pringithub/stylosynth-555/hardware/kicad/drc_report.txt

** Drc report for /home/pring5/Projects/Personal/Active/pcb_synthesizer/hardware/kicad/stylosynth.kicad_pcb **
** Created on 2026-09-23 13:34:57 **

** Found 112 DRC violations **
[silk_overlap]: Silkscreen overlap
    Rule: board setup constraints silk; Severity: warning
    @(172.6000 mm, 60.5000 mm): PCB Text 'STYLUS' on F.Silkscreen
    @(171.0000 mm, 61.0000 mm): Reference 'C7'
[silk_overlap]: Silkscreen overlap
    Rule: board setup constraints silk; Severity: warning
    @(161.1500 mm, 72.2100 mm): Line on F.Silkscreen
    @(161.5000 mm, 65.0000 mm): Reference 'C6'
[silk_overlap]: Silkscreen overlap
    Rule: board setup constraints silk; Severity: warning
    @(169.1300 mm, 70.7750 mm): Reference 'R5'
    @(168.0000 mm, 72.0450 mm): Circle on F.Silkscreen
[silk_overlap]: Silkscreen overlap
    Rule: board setup constraints silk; Severity: warning
    @(174.6300 mm, 64.7750 mm): Reference 'R3'
    @(174.7200 mm, 62.1300 mm): Line on F.Silkscreen
[silk_overlap]: Silkscreen overlap
    Rule: board setup constraints silk; Severity: warning
    @(150.0000 mm, 90.5450 mm): Circle on F.Silkscreen
    @(151.6300 mm, 89.2750 mm): Reference 'R103'
[silk_overlap]: Silkscreen overlap
    Rule: board setup constraints silk; Severity: warning
    @(155.6300 mm, 89.2750 mm): Reference 'R102'
    @(154.0000 mm, 90.5450 mm): Circle on F.Silkscreen
[silk_overlap]: Silkscreen overlap
    Rule: board setup constraints silk; Severity: warning
    @(62.0973 mm, 84.7500 mm): Reference 'C1'
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
    Local override; Severity: warning
    @(168.0000 mm, 72.0450 mm): Footprint R4
[lib_footprint_issues]: Footprint 'R_Axial_DIN0207_L6.3mm_D2.5mm_P2.54mm_Vertical' not found in library 'Resistor_THT'.
    Local override; Severity: warning
    @(112.6500 mm, 90.5450 mm): Footprint R112
[lib_footprint_issues]: Footprint 'C_Disc_D5.0mm_W2.5mm_P5.00mm' not found in library 'Capacitor_THT'.
    Local override; Severity: warning
    @(174.5000 mm, 72.0000 mm): Footprint C8
[lib_footprint_issues]: Footprint 'MountingHole_3.2mm_M3' not found in library 'MountingHole'.
    Local override; Severity: warning
    @(54.0000 mm, 134.0000 mm): Footprint H3
[lib_footprint_issues]: Footprint 'R_Axial_DIN0207_L6.3mm_D2.5mm_P2.54mm_Vertical' not found in library 'Resistor_THT'.
    Local override; Severity: warning
    @(98.0000 mm, 90.5450 mm): Footprint R115
[lib_footprint_issues]: Footprint 'TO-92_Inline' not found in library 'Package_TO_SOT_THT'.
    Local override; Severity: warning
    @(60.7300 mm, 109.3600 mm): Footprint U1
[lib_footprint_issues]: Footprint 'CP_Radial_D5.0mm_P2.00mm' not found in library 'Capacitor_THT'.
    Local override; Severity: warning
    @(119.0449 mm, 78.0000 mm): Footprint C12
[lib_footprint_issues]: Footprint 'DIP-8_W7.62mm_Socket' not found in library 'Package_DIP'.
    Local override; Severity: warning
    @(152.2000 mm, 63.2000 mm): Footprint U2
[lib_footprint_issues]: Footprint 'C_Disc_D5.0mm_W2.5mm_P5.00mm' not found in library 'Capacitor_THT'.
    Local override; Severity: warning
    @(128.0000 mm, 79.5000 mm): Footprint C14
[lib_footprint_issues]: Footprint 'C_Disc_D5.0mm_W2.5mm_P5.00mm' not found in library 'Capacitor_THT'.
    Local override; Severity: warning
    @(104.0000 mm, 68.5000 mm): Footprint C9
[lib_footprint_issues]: Footprint 'R_Axial_DIN0207_L6.3mm_D2.5mm_P2.54mm_Vertical' not found in library 'Resistor_THT'.
    Local override; Severity: warning
    @(122.0000 mm, 90.5450 mm): Footprint R110
[lib_footprint_issues]: Footprint 'C_Rect_L7.2mm_W3.5mm_P5.00mm_FKS2_FKP2_MKS2_MKP2' not found in library 'Capacitor_THT'.
    Local override; Severity: warning
    @(168.5000 mm, 64.0000 mm): Footprint C7
[lib_footprint_issues]: Footprint 'R_Axial_DIN0207_L6.3mm_D2.5mm_P2.54mm_Vertical' not found in library 'Resistor_THT'.
    Local override; Severity: warning
    @(133.0000 mm, 77.0450 mm): Footprint R8
[lib_footprint_issues]: Footprint 'CP_Radial_D5.0mm_P2.00mm' not found in library 'Capacitor_THT'.
    Local override; Severity: warning
    @(77.0449 mm, 75.0000 mm): Footprint C19
[lib_footprint_issues]: Footprint 'R_Axial_DIN0207_L6.3mm_D2.5mm_P2.54mm_Vertical' not found in library 'Resistor_THT'.
    Local override; Severity: warning
    @(108.5000 mm, 66.0450 mm): Footprint R7
[lib_footprint_issues]: Footprint 'SW_CK_JS202011CQN_DPDT_Straight' not found in library 'Button_Switch_THT'.
    Local override; Severity: warning
    @(121.3000 mm, 44.3575 mm): Footprint SW3
[lib_footprint_issues]: Footprint 'R_Axial_DIN0207_L6.3mm_D2.5mm_P2.54mm_Vertical' not found in library 'Resistor_THT'.
    Local override; Severity: warning
    @(171.5000 mm, 72.0450 mm): Footprint R5
[lib_footprint_issues]: Footprint 'R_Axial_DIN0207_L6.3mm_D2.5mm_P2.54mm_Vertical' not found in library 'Resistor_THT'.
    Local override; Severity: warning
    @(126.0000 mm, 90.5450 mm): Footprint R109
[lib_footprint_issues]: Footprint 'R_Axial_DIN0207_L6.3mm_D2.5mm_P2.54mm_Vertical' not found in library 'Resistor_THT'.
    Local override; Severity: warning
    @(150.0000 mm, 90.5450 mm): Footprint R104
[lib_footprint_issues]: Footprint 'R_Axial_DIN0207_L6.3mm_D2.5mm_P2.54mm_Vertical' not found in library 'Resistor_THT'.
    Local override; Severity: warning
    @(83.0000 mm, 66.0450 mm): Footprint R13
[lib_footprint_issues]: Footprint 'CP_Radial_D5.0mm_P2.00mm' not found in library 'Capacitor_THT'.
    Local override; Severity: warning
    @(61.0449 mm, 117.0000 mm): Footprint C4
[lib_footprint_issues]: Footprint 'MountingHole_3.2mm_M3' not found in library 'MountingHole'.
    Local override; Severity: warning
    @(54.0000 mm, 63.0000 mm): Footprint H1
[lib_footprint_issues]: Footprint 'C_Disc_D5.0mm_W2.5mm_P5.00mm' not found in library 'Capacitor_THT'.
    Local override; Severity: warning
    @(137.0000 mm, 79.5000 mm): Footprint C15
[lib_footprint_issues]: Footprint 'R_Axial_DIN0207_L6.3mm_D2.5mm_P2.54mm_Vertical' not found in library 'Resistor_THT'.
    Local override; Severity: warning
    @(158.0000 mm, 90.5450 mm): Footprint R102
[lib_footprint_issues]: Footprint 'CP_Radial_D8.0mm_P3.50mm' not found in library 'Capacitor_THT'.
    Local override; Severity: warning
    @(138.3473 mm, 66.0000 mm): Footprint C16
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
    Local override; Severity: warning
    @(161.5000 mm, 45.7250 mm): Footprint J4
[lib_footprint_issues]: Footprint 'R_Axial_DIN0207_L6.3mm_D2.5mm_P2.54mm_Vertical' not found in library 'Resistor_THT'.
    Local override; Severity: warning
    @(55.0000 mm, 110.0450 mm): Footprint R2
[lib_footprint_issues]: Footprint 'MountingHole_3.2mm_M3' not found in library 'MountingHole'.
    Local override; Severity: warning
    @(182.0000 mm, 134.0000 mm): Footprint H4
[lib_footprint_issues]: Footprint 'R_Axial_DIN0207_L6.3mm_D2.5mm_P2.54mm_Vertical' not found in library 'Resistor_THT'.
    Local override; Severity: warning
    @(102.0000 mm, 90.5450 mm): Footprint R114
[lib_footprint_issues]: Footprint 'SW_CK_JS202011CQN_DPDT_Straight' not found in library 'Button_Switch_THT'.
    Local override; Severity: warning
    @(132.3000 mm, 44.3575 mm): Footprint SW4
[lib_footprint_issues]: Footprint 'Potentiometer_Bourns_3296W_Vertical' not found in library 'Potentiometer_THT'.
    Local override; Severity: warning
    @(175.5500 mm, 79.0000 mm): Footprint RV5
[lib_footprint_issues]: Footprint 'Potentiometer_Bourns_3296W_Vertical' not found in library 'Potentiometer_THT'.
    Local override; Severity: warning
    @(66.5500 mm, 82.0000 mm): Footprint RV2
[lib_footprint_issues]: Footprint 'R_Axial_DIN0207_L6.3mm_D2.5mm_P2.54mm_Vertical' not found in library 'Resistor_THT'.
    Local override; Severity: warning
    @(72.6500 mm, 90.5450 mm): Footprint R120
[lib_footprint_issues]: Footprint 'R_Axial_DIN0207_L6.3mm_D2.5mm_P2.54mm_Vertical' not found in library 'Resistor_THT'.
    Local override; Severity: warning
    @(130.0000 mm, 90.5450 mm): Footprint R108
[lib_footprint_issues]: Footprint 'Potentiometer_Alps_RK09K_Single_Vertical' not found in library 'Potentiometer_THT'.
    Local override; Severity: warning
    @(82.1500 mm, 45.5000 mm): Footprint RV3
[lib_footprint_issues]: Footprint 'C_Disc_D5.0mm_W2.5mm_P5.00mm' not found in library 'Capacitor_THT'.
    Local override; Severity: warning
    @(72.5000 mm, 78.5000 mm): Footprint C17
[lib_footprint_issues]: Footprint 'Jack_3.5mm_CUI_SJ1-3535NG_Horizontal' not found in library 'Connector_Audio'.
    Local override; Severity: warning
    @(172.5000 mm, 45.7250 mm): Footprint J3
[lib_footprint_issues]: Footprint 'DIP-8_W7.62mm_Socket' not found in library 'Package_DIP'.
    Local override; Severity: warning
    @(117.2000 mm, 63.2000 mm): Footprint U4
[lib_footprint_issues]: Footprint 'R_Axial_DIN0207_L6.3mm_D2.5mm_P2.54mm_Vertical' not found in library 'Resistor_THT'.
    Local override; Severity: warning
    @(72.5000 mm, 66.0450 mm): Footprint R10
[lib_footprint_issues]: Footprint 'DIP-16_W7.62mm_Socket' not found in library 'Package_DIP'.
    Local override; Severity: warning
    @(92.2000 mm, 63.1000 mm): Footprint U3
[lib_footprint_issues]: Footprint 'C_Rect_L7.2mm_W3.5mm_P5.00mm_FKS2_FKP2_MKS2_MKP2' not found in library 'Capacitor_THT'.
    Local override; Severity: warning
    @(108.5000 mm, 78.5000 mm): Footprint C10
[lib_footprint_issues]: Footprint 'R_Axial_DIN0207_L6.3mm_D2.5mm_P2.54mm_Vertical' not found in library 'Resistor_THT'.
    Local override; Severity: warning
    @(183.0000 mm, 79.0450 mm): Footprint R6
[lib_footprint_issues]: Footprint 'C_Disc_D5.0mm_W2.5mm_P5.00mm' not found in library 'Capacitor_THT'.
    Local override; Severity: warning
    @(55.0000 mm, 102.5000 mm): Footprint C2
[lib_footprint_issues]: Footprint 'SW_CK_JS202011CQN_DPDT_Straight' not found in library 'Button_Switch_THT'.
    Local override; Severity: warning
    @(99.3000 mm, 44.3575 mm): Footprint SW5
[lib_footprint_issues]: Footprint 'R_Axial_DIN0207_L6.3mm_D2.5mm_P2.54mm_Vertical' not found in library 'Resistor_THT'.
    Local override; Severity: warning
    @(154.0000 mm, 90.5450 mm): Footprint R103
[lib_footprint_issues]: Footprint 'R_Axial_DIN0207_L6.3mm_D2.5mm_P2.54mm_Vertical' not found in library 'Resistor_THT'.
    Local override; Severity: warning
    @(142.0000 mm, 78.0450 mm): Footprint R9
[lib_footprint_issues]: Footprint 'R_Axial_DIN0207_L6.3mm_D2.5mm_P2.54mm_Vertical' not found in library 'Resistor_THT'.
    Local override; Severity: warning
    @(86.5000 mm, 66.0450 mm): Footprint R14
[lib_footprint_issues]: Footprint 'C_Rect_L7.2mm_W5.5mm_P5.00mm_FKS2_FKP2_MKS2_MKP2' not found in library 'Capacitor_THT'.
    Local override; Severity: warning
    @(61.0000 mm, 75.5000 mm): Footprint C18
[lib_footprint_issues]: Footprint 'R_Axial_DIN0207_L6.3mm_D2.5mm_P2.54mm_Vertical' not found in library 'Resistor_THT'.
    Local override; Severity: warning
    @(78.0000 mm, 90.5450 mm): Footprint R119
[lib_footprint_issues]: Footprint 'R_Axial_DIN0207_L6.3mm_D2.5mm_P2.54mm_Vertical' not found in library 'Resistor_THT'.
    Local override; Severity: warning
    @(79.5000 mm, 66.0450 mm): Footprint R12
[lib_footprint_issues]: Footprint 'DIP-8_W7.62mm_Socket' not found in library 'Package_DIP'.
    Local override; Severity: warning
    @(60.2000 mm, 62.2000 mm): Footprint U5
[lib_footprint_issues]: Footprint 'CP_Radial_D5.0mm_P2.00mm' not found in library 'Capacitor_THT'.
    Local override; Severity: warning
    @(83.5449 mm, 75.0000 mm): Footprint C20
[lib_footprint_issues]: Footprint 'R_Axial_DIN0207_L6.3mm_D2.5mm_P2.54mm_Vertical' not found in library 'Resistor_THT'.
    Local override; Severity: warning
    @(107.3500 mm, 90.5450 mm): Footprint R113
[lib_footprint_issues]: Footprint 'C_Disc_D5.0mm_W2.5mm_P5.00mm' not found in library 'Capacitor_THT'.
    Local override; Severity: warning
    @(164.0000 mm, 67.5000 mm): Footprint C6
[lib_footprint_issues]: Footprint 'R_Axial_DIN0207_L6.3mm_D2.5mm_P2.54mm_Vertical' not found in library 'Resistor_THT'.
    Local override; Severity: warning
    @(144.6500 mm, 90.5450 mm): Footprint R105
[lib_footprint_issues]: Footprint 'Potentiometer_Bourns_3296W_Vertical' not found in library 'Potentiometer_THT'.
    Local override; Severity: warning
    @(173.0000 mm, 93.4500 mm): Footprint RV4
[lib_footprint_issues]: Footprint 'JST_XH_B2B-XH-A_1x02_P2.50mm_Vertical' not found in library 'Connector_JST'.
    Local override; Severity: warning
    @(147.7500 mm, 78.5250 mm): Footprint J5
[lib_footprint_issues]: Footprint 'JST_XH_B2B-XH-A_1x02_P2.50mm_Vertical' not found in library 'Connector_JST'.
    Local override; Severity: warning
    @(61.2500 mm, 127.5250 mm): Footprint J2
[silk_edge_clearance]: Silkscreen clipped by board edge
    Rule: board setup constraints silk; Severity: warning
    @(53.0000 mm, 40.0000 mm): Line on Edge.Cuts
    @(148.2000 mm, 40.3500 mm): Reference 'RV1'
[silk_edge_clearance]: Silkscreen clipped by board edge
    Rule: board setup constraints silk; Severity: warning
    @(53.0000 mm, 40.0000 mm): Line on Edge.Cuts
    @(88.2000 mm, 40.3500 mm): Reference 'RV3'
[track_dangling]: Track has unconnected end
    Local override; Severity: warning
    @(55.2841 mm, 78.5000 mm): Track [+5V] on B.Cu, length 2.6440 mm
[track_dangling]: Track has unconnected end
    Local override; Severity: warning
    @(55.2841 mm, 78.5000 mm): Track [+5V] on F.Cu, length 2.6440 mm

** Found 0 unconnected pads **

** Found 0 Footprint errors **

** End of Report **
