pringithub/stylosynth-555/docs/report/figures/audio.pdf

### Tone switch response (volume max)

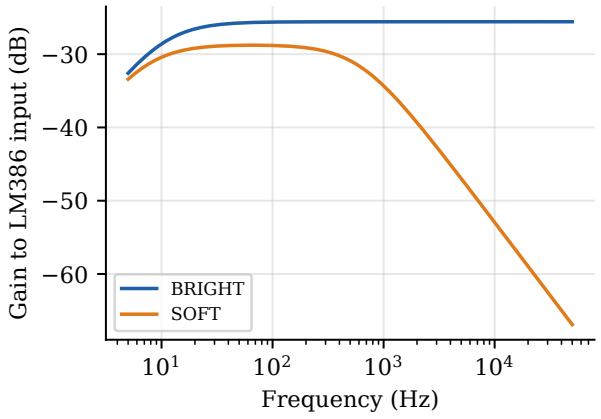
[picture p17: figure]
Frequency (Hz); Gain to LM386 input (dB); BRIGHT SOFT
