pringithub/stylosynth-555/docs/report/figures/lfo.pdf

Vibrato LFO (RATE trimmer mid-travel) and resulting pitch modulation at full DEPTH

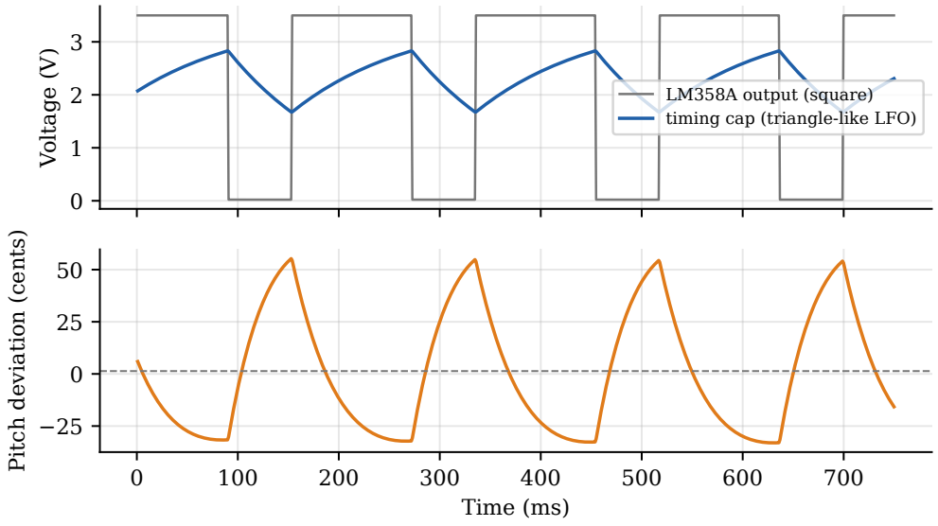
[picture p18: figure]
Voltage (V); LM358A output (square) timing cap (triangle-like LFO); Time (ms); Pitch deviation (cents)
