pringithub/stylosynth-555/docs/report/figures/lfo_rate.pdf

### Vibrato rate range

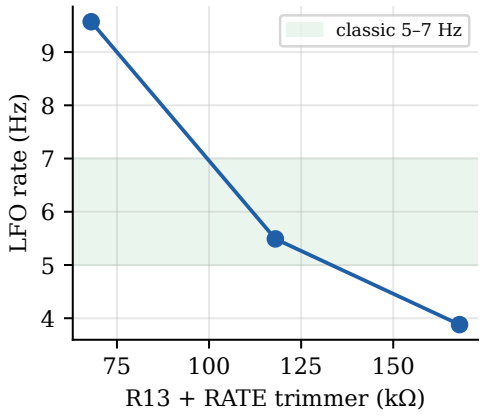
[picture p19: figure]
R13 + RATE trimmer (kΩ); LFO rate (Hz); classic 5–7 Hz
