pringithub/stylosynth-555/docs/report/figures/monte_carlo.pdf

1 | 3 | 5 | 7 | 9 | 11 13 15 17 19 Key

−4

−2

0

2

4

Error after calibration (cents)

### Per-key error, 1 % resistors (box: IQR, whiskers: 95 %)

±5 cents

0 | 2 | 4
Worst key per build (cents)

0

200

400

600

800

1000

Builds

### 2000 simulated builds

1 % resistors
0.1 % resistors
