pringithub/stylosynth-555/docs/report/figures/power.pdf

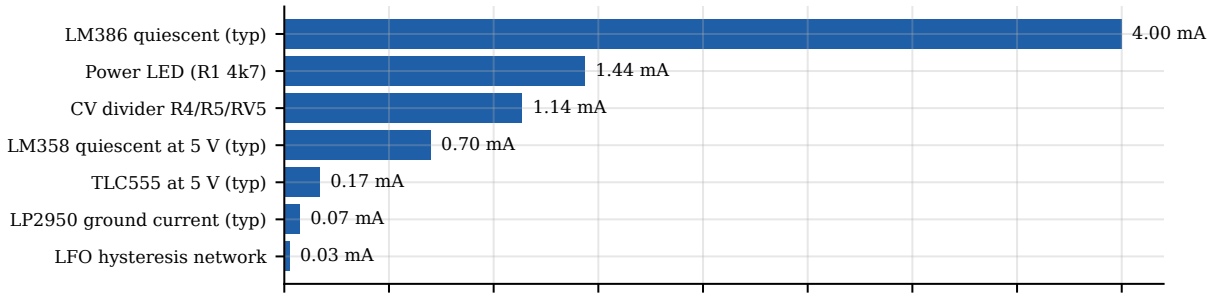
[picture p20: figure]
LFO hysteresis network; LP2950 ground current (typ); TLC555 at 5 V (typ); LM358 quiescent at 5 V (typ); CV divider R4/R5/RV5; Power LED (R1 4k7); LM386 quiescent (typ)

0.0 | 0.5 | 1.0 | 1.5 | 2.0 | 2.5 | 3.0 | 3.5 | 4.0

## Idle current (mA)

## Idle supply budget: 7.5 mA total (stylus lifted)
