pringithub/stylosynth-555/hardware/design/ladder.csv

segment | key | BASS | LOW | MID | HIGH | f555_Hz | R_fixed | R_cum_nominal | nominal_err_cents
0 | 20 | E3 | E4 | E5 | E6 | 2637.02 | 11k3 | 12300.0 | 11.94
1 | 19 | D#3 | D#4 | D#5 | D#6 | 2489.016 | 750 | 13050.0 | 11.07
2 | 18 | D3 | D4 | D5 | D6 | 2349.318 | 787 | 13837.0 | 11.17
3 | 17 | C#3 | C#4 | C#5 | C#6 | 2217.461 | 845 | 14682.0 | 9.97
4 | 16 | C3 | C4 | C5 | C6 | 2093.005 | 887 | 15569.0 | 9.75
5 | 15 | B2 | B3 | B4 | B5 | 1975.533 | 953 | 16522.0 | 8.16
6 | 14 | A#2 | A#3 | A#4 | A#5 | 1864.655 | 1k | 17522.0 | 7.61
7 | 13 | A2 | A3 | A4 | A5 | 1760.0 | 1k05 | 18572.0 | 7.96
8 | 12 | G#2 | G#3 | G#4 | G#5 | 1661.219 | 1k13 | 19702.0 | 6.76
9 | 11 | G2 | G3 | G4 | G5 | 1567.982 | 1k18 | 20882.0 | 7.04
10 | 10 | F#2 | F#3 | F#4 | F#5 | 1479.978 | 1k27 | 22152.0 | 5.77
11 | 9 | F2 | F3 | F4 | F5 | 1396.913 | 1k33 | 23482.0 | 5.71
12 | 8 | E2 | E3 | E4 | E5 | 1318.51 | 1k4 | 24882.0 | 6.27
13 | 7 | D#2 | D#3 | D#4 | D#5 | 1244.508 | 1k5 | 26382.0 | 5.72
14 | 6 | D2 | D3 | D4 | D5 | 1174.659 | 1k58 | 27962.0 | 5.76
15 | 5 | C#2 | C#3 | C#4 | C#5 | 1108.731 | 1k69 | 29652.0 | 4.86
16 | 4 | C2 | C3 | C4 | C5 | 1046.502 | 1k78 | 31432.0 | 4.59
17 | 3 | B1 | B2 | B3 | B4 | 987.767 | 1k87 | 33302.0 | 5.16
18 | 2 | A#1 | A#2 | A#3 | A#4 | 932.328 | 2k | 35302.0 | 4.78
19 | 1 | A1 | A2 | A3 | A4 | 880.0 | 2k15 | 37452.0 | 2.98
