pringithub/stylosynth-555/docs/renders/pcb-bottom.png

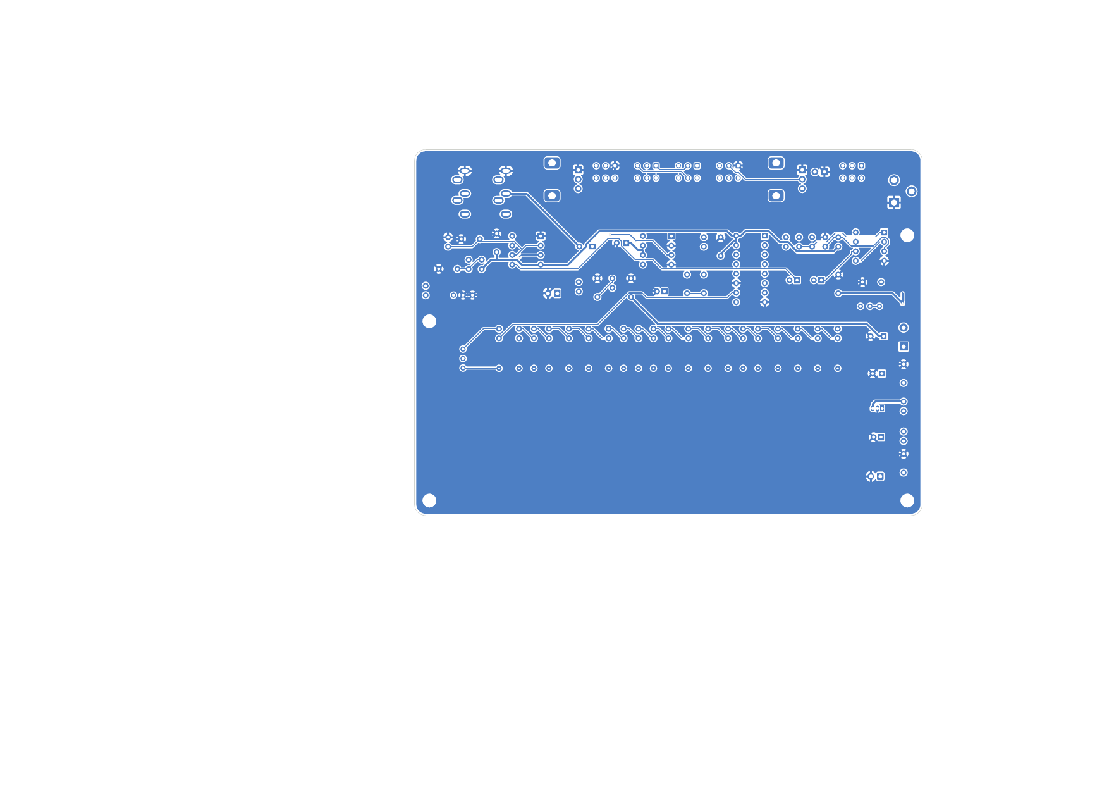
docs/renders/pcb-bottom.png
