pringithub/stylosynth-555/docs/renders/pcb-top.png

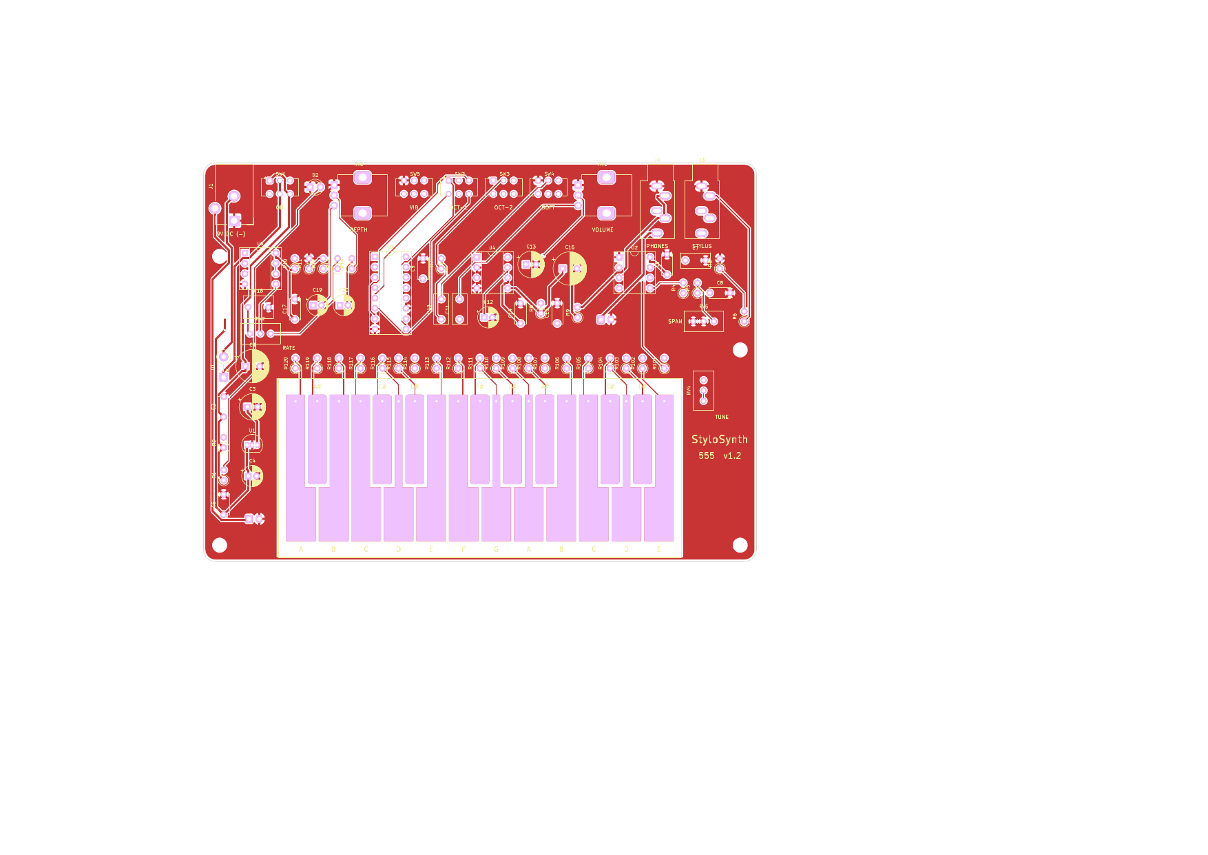
docs/renders/pcb-top.png
