pringithub/stylosynth-555/enclosure/out/textures/pcb_bottom.png

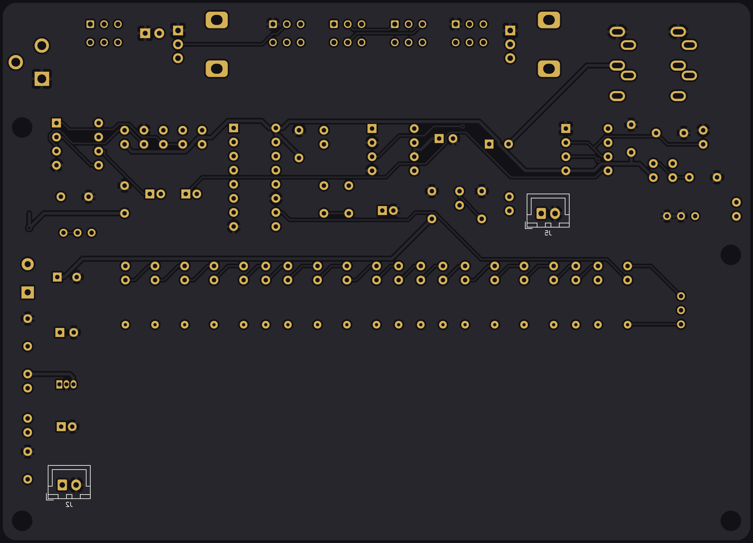
enclosure/out/textures/pcb_bottom.png
