pringithub/stylosynth-555/enclosure/out/textures/pcb_top.png

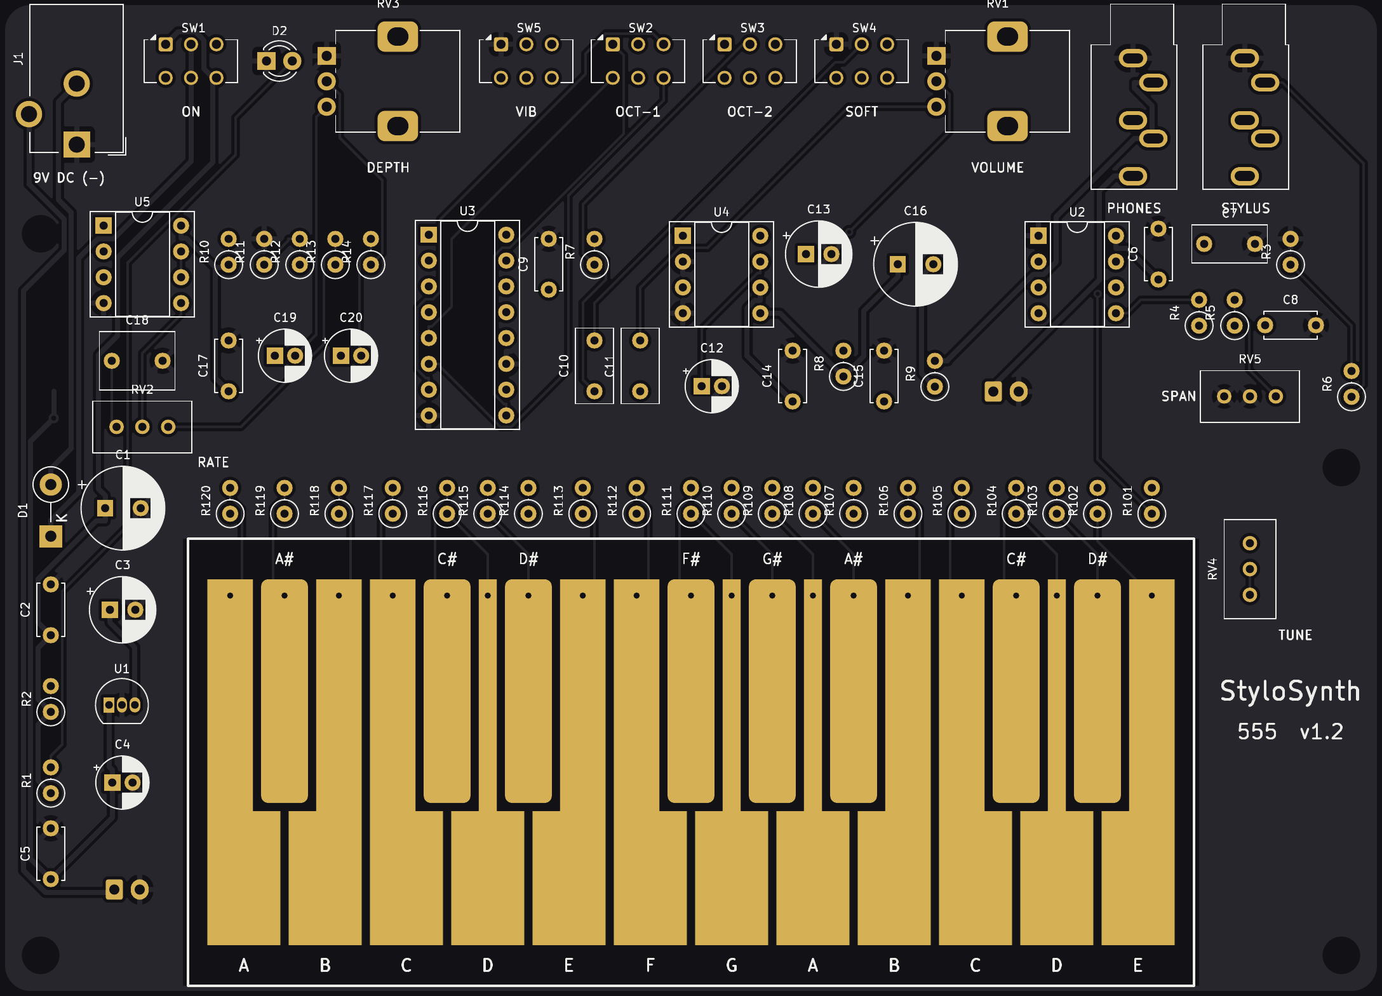
enclosure/out/textures/pcb_top.png
