pringithub/stylosynth-555/bom/bom.md

# StyloSynth-555 BOM

Generated by `hardware/scripts/gen_bom.py` from `circuit.py`. Do not edit by hand.

- On-board parts: **76** in **64** line items. Off-board items are listed at the end.
- Rough cost for one unit (parts plus 1/5 of a 5-board PCB order): **~$66 USD**. Prices are indicative only.
- **Verify = yes**: the MPN is a typical example. Confirm stock, lead pitch/diameter and shaft style before ordering.
- Order the PCB with an **ENIG** finish, because the key pads are exposed copper.
- Search: [Mouser](https://www.mouser.com/) · [DigiKey](https://www.digikey.com/) · [LCSC](https://www.lcsc.com/)

| Qty | References | Value | Description | Footprint | Manufacturer | MPN | Verify | Est. unit USD | Est. line USD |
|---|---|---|---|---|---|---|---|---|---|
| 2 | C1, C16 | 220u | Capacitor, electrolytic 220uF 16V | CP_Radial_D8.0mm_P3.50mm | Panasonic | EEU-FC1C221 (220uF 16V, 8 mm, 3.5 mm pitch) | yes | 0.45 | 0.90 |
| 6 | C2, C5, C6, C9, C14, C17 | 100n | Capacitor, ceramic X7R 50V | C_Disc_D5.0mm_W2.5mm_P5.00mm | KEMET | C322C104K5R5TA | yes | 0.25 | 1.50 |
| 2 | C3, C13 | 100u | Capacitor, electrolytic 100uF 16V | CP_Radial_D6.3mm_P2.50mm | Panasonic | EEU-FC1C101 (100uF 16V, 6.3 mm, 2.5 mm pitch) | yes | 0.35 | 0.70 |
| 2 | C4, C12 | 10u | Capacitor, electrolytic 10uF 25V | CP_Radial_D5.0mm_P2.00mm | Panasonic | EEU-FC1E100 (10uF 25V, 5 mm, 2 mm pitch) | yes | 0.25 | 0.50 |
| 1 | C7 | 22n | Capacitor, polypropylene film 22nF 2.5% 100V (timing) | C_Rect_L7.2mm_W3.5mm_P5.00mm_FKS2_FKP2_MKS2_MKP2 | WIMA | MKP2 22nF 100V 2.5% 5 mm (polypropylene) | yes | 0.60 | 0.60 |
| 1 | C8 | 10n | Capacitor, ceramic X7R 50V | C_Disc_D5.0mm_W2.5mm_P5.00mm | KEMET | C322C103K5R5TA | yes | 0.25 | 0.25 |
| 1 | C10 | 47n | Capacitor, polyester film 47nF 63V | C_Rect_L7.2mm_W3.5mm_P5.00mm_FKS2_FKP2_MKS2_MKP2 | WIMA | MKS2 47nF 63V 5 mm | yes | 0.35 | 0.35 |
| 1 | C11 | 100n | Capacitor, polyester film 100nF 63V | C_Rect_L7.2mm_W3.5mm_P5.00mm_FKS2_FKP2_MKS2_MKP2 | WIMA | MKS2 100nF 63V 5 mm | yes | 0.35 | 0.35 |
| 1 | C15 | 47n | Capacitor, ceramic X7R 50V | C_Disc_D5.0mm_W2.5mm_P5.00mm | KEMET | C322C473K5R5TA | yes | 0.25 | 0.25 |
| 1 | C18 | 1u | Capacitor, polyester film 1uF 63V | C_Rect_L7.2mm_W5.5mm_P5.00mm_FKS2_FKP2_MKS2_MKP2 | WIMA | MKS2 1uF 63V 5 mm | yes | 0.60 | 0.60 |
| 1 | C19 | 22u | Capacitor, aluminium electrolytic 25V | CP_Radial_D5.0mm_P2.00mm | Panasonic | EEU-FC1E220 (22uF 25V, 5 mm, 2 mm pitch) | yes | 0.30 | 0.30 |
| 1 | C20 | 47u | Capacitor, aluminium electrolytic 25V | CP_Radial_D5.0mm_P2.00mm | Panasonic | 47uF 16V, 5 mm dia, 2 mm pitch (FC/FR series) | yes | 0.30 | 0.30 |
| 1 | D1 | 1N5819 | Schottky diode 40V 1A (reverse-polarity protection) | D_DO-41_SOD81_P5.08mm_Vertical_KathodeUp | onsemi / Vishay | 1N5819 | no | 0.20 | 0.20 |
| 1 | D2 | PWR | LED 3mm red, diffused | LED_D3.0mm | Kingbright | WP710A10ID (3 mm red diffused) | yes | 0.25 | 0.25 |
| 1 | J1 | 9V DC (centre -) | DC barrel jack 2.1mm with switch, CUI PJ-102AH | BarrelJack_CUI_PJ-102AH_Horizontal | Same Sky (CUI) | PJ-102AH (5.5x2.1 mm) | yes | 0.90 | 0.90 |
| 1 | J2 | 9V BATT | JST XH 2-pin header (9V battery snap) | JST_XH_B2B-XH-A_1x02_P2.50mm_Vertical | JST | B2B-XH-A(LF)(SN) | no | 0.15 | 0.15 |
| 1 | J3 | STYLUS | 3.5mm TRS jack horizontal, switched, CUI SJ1-3535NG | Jack_3.5mm_CUI_SJ1-3535NG_Horizontal | Same Sky (CUI) | SJ1-3535NG | no | 1.30 | 1.30 |
| 1 | J4 | PHONES | 3.5mm TRS jack horizontal, switched, CUI SJ1-3535NG | Jack_3.5mm_CUI_SJ1-3535NG_Horizontal | Same Sky (CUI) | SJ1-3535NG | no | 1.30 | 1.30 |
| 1 | J5 | SPEAKER | JST XH 2-pin header (speaker) | JST_XH_B2B-XH-A_1x02_P2.50mm_Vertical | JST | B2B-XH-A(LF)(SN) | no | 0.15 | 0.15 |
| 2 | R1, R14 | 4k7 | Resistor, metal film 1% 0.25W | R_Axial_DIN0207_L6.3mm_D2.5mm_P2.54mm_Vertical | Yageo / generic | 4k7 metal film 1% 0.25 W (e.g. Yageo MFR-25 series) | no | 0.03 | 0.06 |
| 1 | R2 | 47 | Resistor, metal film 1% 0.25W | R_Axial_DIN0207_L6.3mm_D2.5mm_P2.54mm_Vertical | Yageo / generic | 47 metal film 1% 0.25 W (e.g. Yageo MFR-25 series) | no | 0.03 | 0.03 |
| 1 | R3 | 10M | Resistor, metal film 1% 0.25W | R_Axial_DIN0207_L6.3mm_D2.5mm_P2.54mm_Vertical | Yageo / generic | 10M metal film 1% 0.25 W (e.g. Yageo MFR-25 series) | no | 0.03 | 0.03 |
| 2 | R4, R114 | 1k5 | Resistor, metal film 1% 0.25W | R_Axial_DIN0207_L6.3mm_D2.5mm_P2.54mm_Vertical | Yageo / generic | 1k5 metal film 1% 0.25 W (e.g. Yageo MFR-25 series) | no | 0.03 | 0.06 |
| 1 | R5 | 2k4 | Resistor, metal film 1% 0.25W | R_Axial_DIN0207_L6.3mm_D2.5mm_P2.54mm_Vertical | Yageo / generic | 2k4 metal film 1% 0.25 W (e.g. Yageo MFR-25 series) | no | 0.03 | 0.03 |
| 1 | R6 | 100 | Resistor, metal film 1% 0.25W | R_Axial_DIN0207_L6.3mm_D2.5mm_P2.54mm_Vertical | Yageo / generic | 100 metal film 1% 0.25 W (e.g. Yageo MFR-25 series) | no | 0.03 | 0.03 |
| 1 | R7 | 150k | Resistor, metal film 1% 0.25W | R_Axial_DIN0207_L6.3mm_D2.5mm_P2.54mm_Vertical | Yageo / generic | 150k metal film 1% 0.25 W (e.g. Yageo MFR-25 series) | no | 0.03 | 0.03 |
| 1 | R8 | 10 | Resistor, metal film 1% 0.25W | R_Axial_DIN0207_L6.3mm_D2.5mm_P2.54mm_Vertical | Yageo / generic | 10 metal film 1% 0.25 W (e.g. Yageo MFR-25 series) | no | 0.03 | 0.03 |
| 1 | R9 | 220 | Resistor, metal film 1% 0.25W | R_Axial_DIN0207_L6.3mm_D2.5mm_P2.54mm_Vertical | Yageo / generic | 220 metal film 1% 0.25 W (e.g. Yageo MFR-25 series) | no | 0.03 | 0.03 |
| 3 | R10, R11, R12 | 100k | Resistor, metal film 1% 0.25W | R_Axial_DIN0207_L6.3mm_D2.5mm_P2.54mm_Vertical | Yageo / generic | 100k metal film 1% 0.25 W (e.g. Yageo MFR-25 series) | no | 0.03 | 0.09 |
| 1 | R13 | 68k | Resistor, metal film 1% 0.25W | R_Axial_DIN0207_L6.3mm_D2.5mm_P2.54mm_Vertical | Yageo / generic | 68k metal film 1% 0.25 W (e.g. Yageo MFR-25 series) | no | 0.03 | 0.03 |
| 1 | R101 | 11k3 | Resistor, metal film 1% 0.25W | R_Axial_DIN0207_L6.3mm_D2.5mm_P2.54mm_Vertical | Yageo / generic | 11k3 metal film 1% 0.25 W (e.g. Yageo MFR-25 series) | no | 0.03 | 0.03 |
| 1 | R102 | 750 | Resistor, metal film 1% 0.25W | R_Axial_DIN0207_L6.3mm_D2.5mm_P2.54mm_Vertical | Yageo / generic | 750 metal film 1% 0.25 W (e.g. Yageo MFR-25 series) | no | 0.03 | 0.03 |
| 1 | R103 | 787 | Resistor, metal film 1% 0.25W | R_Axial_DIN0207_L6.3mm_D2.5mm_P2.54mm_Vertical | Yageo / generic | 787 metal film 1% 0.25 W (e.g. Yageo MFR-25 series) | no | 0.03 | 0.03 |
| 1 | R104 | 845 | Resistor, metal film 1% 0.25W | R_Axial_DIN0207_L6.3mm_D2.5mm_P2.54mm_Vertical | Yageo / generic | 845 metal film 1% 0.25 W (e.g. Yageo MFR-25 series) | no | 0.03 | 0.03 |
| 1 | R105 | 887 | Resistor, metal film 1% 0.25W | R_Axial_DIN0207_L6.3mm_D2.5mm_P2.54mm_Vertical | Yageo / generic | 887 metal film 1% 0.25 W (e.g. Yageo MFR-25 series) | no | 0.03 | 0.03 |
| 1 | R106 | 953 | Resistor, metal film 1% 0.25W | R_Axial_DIN0207_L6.3mm_D2.5mm_P2.54mm_Vertical | Yageo / generic | 953 metal film 1% 0.25 W (e.g. Yageo MFR-25 series) | no | 0.03 | 0.03 |
| 1 | R107 | 1k | Resistor, metal film 1% 0.25W | R_Axial_DIN0207_L6.3mm_D2.5mm_P2.54mm_Vertical | Yageo / generic | 1k metal film 1% 0.25 W (e.g. Yageo MFR-25 series) | no | 0.03 | 0.03 |
| 1 | R108 | 1k05 | Resistor, metal film 1% 0.25W | R_Axial_DIN0207_L6.3mm_D2.5mm_P2.54mm_Vertical | Yageo / generic | 1k05 metal film 1% 0.25 W (e.g. Yageo MFR-25 series) | no | 0.03 | 0.03 |
| 1 | R109 | 1k13 | Resistor, metal film 1% 0.25W | R_Axial_DIN0207_L6.3mm_D2.5mm_P2.54mm_Vertical | Yageo / generic | 1k13 metal film 1% 0.25 W (e.g. Yageo MFR-25 series) | no | 0.03 | 0.03 |
| 1 | R110 | 1k18 | Resistor, metal film 1% 0.25W | R_Axial_DIN0207_L6.3mm_D2.5mm_P2.54mm_Vertical | Yageo / generic | 1k18 metal film 1% 0.25 W (e.g. Yageo MFR-25 series) | no | 0.03 | 0.03 |
| 1 | R111 | 1k27 | Resistor, metal film 1% 0.25W | R_Axial_DIN0207_L6.3mm_D2.5mm_P2.54mm_Vertical | Yageo / generic | 1k27 metal film 1% 0.25 W (e.g. Yageo MFR-25 series) | no | 0.03 | 0.03 |
| 1 | R112 | 1k33 | Resistor, metal film 1% 0.25W | R_Axial_DIN0207_L6.3mm_D2.5mm_P2.54mm_Vertical | Yageo / generic | 1k33 metal film 1% 0.25 W (e.g. Yageo MFR-25 series) | no | 0.03 | 0.03 |
| 1 | R113 | 1k4 | Resistor, metal film 1% 0.25W | R_Axial_DIN0207_L6.3mm_D2.5mm_P2.54mm_Vertical | Yageo / generic | 1k4 metal film 1% 0.25 W (e.g. Yageo MFR-25 series) | no | 0.03 | 0.03 |
| 1 | R115 | 1k58 | Resistor, metal film 1% 0.25W | R_Axial_DIN0207_L6.3mm_D2.5mm_P2.54mm_Vertical | Yageo / generic | 1k58 metal film 1% 0.25 W (e.g. Yageo MFR-25 series) | no | 0.03 | 0.03 |
| 1 | R116 | 1k69 | Resistor, metal film 1% 0.25W | R_Axial_DIN0207_L6.3mm_D2.5mm_P2.54mm_Vertical | Yageo / generic | 1k69 metal film 1% 0.25 W (e.g. Yageo MFR-25 series) | no | 0.03 | 0.03 |
| 1 | R117 | 1k78 | Resistor, metal film 1% 0.25W | R_Axial_DIN0207_L6.3mm_D2.5mm_P2.54mm_Vertical | Yageo / generic | 1k78 metal film 1% 0.25 W (e.g. Yageo MFR-25 series) | no | 0.03 | 0.03 |
| 1 | R118 | 1k87 | Resistor, metal film 1% 0.25W | R_Axial_DIN0207_L6.3mm_D2.5mm_P2.54mm_Vertical | Yageo / generic | 1k87 metal film 1% 0.25 W (e.g. Yageo MFR-25 series) | no | 0.03 | 0.03 |
| 1 | R119 | 2k | Resistor, metal film 1% 0.25W | R_Axial_DIN0207_L6.3mm_D2.5mm_P2.54mm_Vertical | Yageo / generic | 2k metal film 1% 0.25 W (e.g. Yageo MFR-25 series) | no | 0.03 | 0.03 |
| 1 | R120 | 2k15 | Resistor, metal film 1% 0.25W | R_Axial_DIN0207_L6.3mm_D2.5mm_P2.54mm_Vertical | Yageo / generic | 2k15 metal film 1% 0.25 W (e.g. Yageo MFR-25 series) | no | 0.03 | 0.03 |
| 1 | RV1 | A10k | Potentiometer 9mm vertical, 10k log, Alps RK09K | Potentiometer_Alps_RK09K_Single_Vertical | Alps Alpine / generic | RK09K series 9 mm vertical, 10k log (A10K), 15 mm shaft | yes | 1.50 | 1.50 |
| 1 | RV2 | 100k | Trimmer 25-turn, Bourns 3296W (vibrato rate) | Potentiometer_Bourns_3296W_Vertical | Bourns | 3296W-1-104LF | no | 1.60 | 1.60 |
| 1 | RV3 | B10k | Potentiometer 9mm vertical, 10k linear, Alps RK09K | Potentiometer_Alps_RK09K_Single_Vertical | Alps Alpine / generic | RK09K series 9 mm vertical, 10k lin (B10K), 15 mm shaft | yes | 1.50 | 1.50 |
| 1 | RV4 | 2k | Trimmer 25-turn, Bourns 3296W (TUNE calibration) | Potentiometer_Bourns_3296W_Vertical | Bourns | 3296W-1-202LF | no | 1.60 | 1.60 |
| 1 | RV5 | 1k | Trimmer 25-turn, Bourns 3296W (SPAN calibration) | Potentiometer_Bourns_3296W_Vertical | Bourns | 3296W-1-102LF | no | 1.60 | 1.60 |
| 1 | SW1 | POWER | Slide switch DPDT, C&K JS202011CQN | SW_CK_JS202011CQN_DPDT_Straight | C&K | JS202011CQN | no | 0.60 | 0.60 |
| 1 | SW2 | OCT -1 | Slide switch DPDT, C&K JS202011CQN | SW_CK_JS202011CQN_DPDT_Straight | C&K | JS202011CQN | no | 0.60 | 0.60 |
| 1 | SW3 | OCT -2 | Slide switch DPDT, C&K JS202011CQN | SW_CK_JS202011CQN_DPDT_Straight | C&K | JS202011CQN | no | 0.60 | 0.60 |
| 1 | SW4 | TONE | Slide switch DPDT, C&K JS202011CQN | SW_CK_JS202011CQN_DPDT_Straight | C&K | JS202011CQN | no | 0.60 | 0.60 |
| 1 | SW5 | VIBRATO | Slide switch DPDT, C&K JS202011CQN | SW_CK_JS202011CQN_DPDT_Straight | C&K | JS202011CQN | no | 0.60 | 0.60 |
| 1 | U1 | LP2950-5.0 | LDO 5V 100mA, TO-92 | TO-92_Inline | Texas Instruments | LP2950ACZ-5.0/NOPB | no | 1.00 | 1.00 |
| 1 | U2 | TLC555 | CMOS 555 timer, DIP-8 (do not substitute NE555) | DIP-8_W7.62mm_Socket | Texas Instruments | TLC555CP | no | 1.10 | 1.10 |
| 1 | U3 | CD4040 | 12-stage binary counter, DIP-16 | DIP-16_W7.62mm_Socket | Texas Instruments | CD4040BE | no | 0.70 | 0.70 |
| 1 | U4 | LM386 | Audio power amplifier, DIP-8 | DIP-8_W7.62mm_Socket | Texas Instruments | LM386N-1/NOPB | no | 1.20 | 1.20 |
| 1 | U5 | LM358 | Dual op-amp, DIP-8 | DIP-8_W7.62mm_Socket | Texas Instruments | LM358P | no | 0.45 | 0.45 |
| 3 | - | - | IC socket DIP-8 (U2, U4, U5) | - | generic | DIP-8 machined socket | yes | 0.30 | 0.90 |
| 1 | - | - | IC socket DIP-16 (U3) | - | generic | DIP-16 machined socket | yes | 0.40 | 0.40 |
| 1 | - | - | Speaker 8 ohm, 1 W min (full-volume output ≈ 0.7 W), 40 mm | - | generic | 8R 1W 40 mm | yes | 2.50 | 2.50 |
| 1 | - | - | 9V battery snap with leads | - | generic | 9V snap, 150 mm leads | yes | 0.40 | 0.40 |
| 4 | - | - | JST XH 2-pin housing + 2 crimp contacts (battery, speaker) | - | JST | XHP-2 + SXH-001T-P0.6 | no | 0.20 | 0.80 |
| 1 | - | - | Stylus: 3.5 mm mono plug + 1 m coiled/flex cable | - | generic | 3.5 mm mono plug + cable | yes | 2.00 | 2.00 |
| 1 | - | - | Stylus tip: 4 mm banana plug or M3 brass screw/insert | - | generic | brass tip | yes | 0.50 | 0.50 |
| 2 | - | - | Knob for 6 mm shaft (volume, depth) | - | generic | 6 mm knob | yes | 0.80 | 1.60 |
| 4 | - | - | Printed tray: M3 heat-set insert, M3 x 5.7 mm (4.0 mm hole) | - | generic | Ruthex-style M3x5.7 | yes | 0.15 | 0.60 |
| 4 | - | - | Printed tray: M3 x 6 mm screw, pan/button head (PCB to tray) | - | generic | ISO 7380 M3x6 | no | 0.05 | 0.20 |
| 4 | - | - | Acrylic: M3 x 25 mm brass hex standoff, female-female | - | generic | M3x25 F-F standoff | yes | 0.25 | 1.00 |
| 8 | - | - | Acrylic: M3 x 6 mm screw (standoffs to PCB and bottom plate) | - | generic | ISO 7380 M3x6 | no | 0.05 | 0.40 |
| 4 | - | - | Acrylic: M3 x 30 mm screw + M3 nut (clamps the ring stack) | - | generic | ISO 7380 M3x30 + DIN 934 | no | 0.10 | 0.40 |
| 1 | - | - | Acrylic: 3 mm clear cast acrylic, laser cut (1 bottom plate + 8 rings, 151 x 113 mm) | - | Ponoko/local laser | see enclosure/out/acrylic/*.dxf | yes | 15.00 | 15.00 |
| 4 | - | - | Rubber foot, adhesive | - | generic | 10 mm bumpon | yes | 0.10 | 0.40 |
| 1 | - | - | PCB 200x120 mm, 2-layer, 1.6 mm, ENIG, black mask/white silk (price per board of 5) | - | JLCPCB/PCBWay | fab order | yes | 12.00 | 12.00 |

**Estimated total: $66.22**
