pringithub/stylosynth-555/enclosure/out/acrylic/ring_x8.dxf

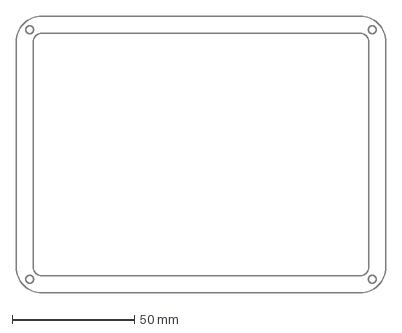
[picture p25: CAD file, 2026-09-23]
enclosure/out/acrylic/ring_x8.dxf
151.0 x 113.0 mm
