pringithub/stylosynth-555/enclosure/out/print/tray.stl

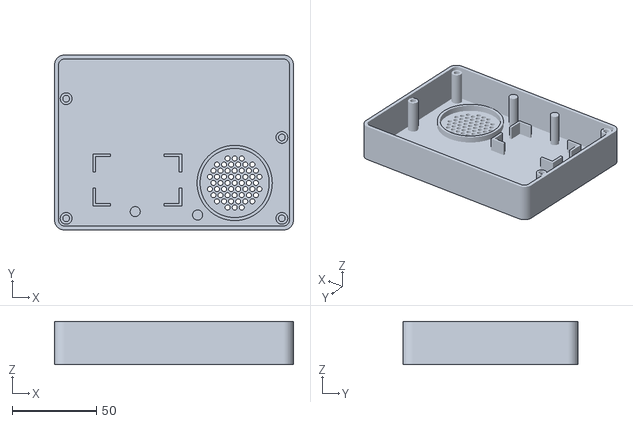
[picture p26: CAD file, 2026-09-23]
enclosure/out/print/tray.stl
141.8 x 103.8 x 25.6
