pringithub/stylosynth-555/hardware/fab/stylosynth.step

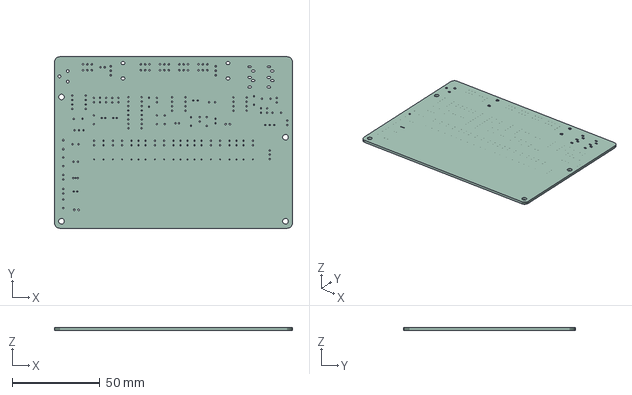
[picture p27: CAD file, 2026-09-23]
hardware/fab/stylosynth.step
136.0 x 98.0 x 1.60 mm
