pringithub/stylosynth-555/enclosure/out/acrylic/bottom_plate_x1.dxf

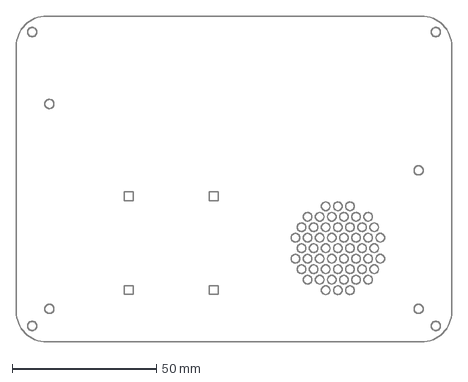
[picture p28: CAD file, 2026-09-23]
enclosure/out/acrylic/bottom_plate_x1.dxf
151.0 x 113.0 mm
