pringithub/stylosynth-555/enclosure/out/print/stylus_body.stl

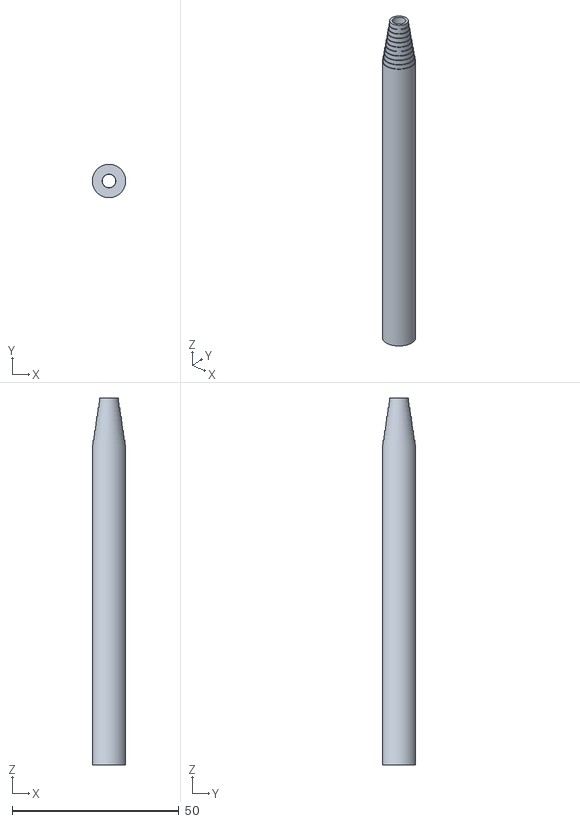
[picture p29: CAD file, 2026-09-23]
enclosure/out/print/stylus_body.stl
10.0 x 10.0 x 110.0
