pringithub/stylosynth-555/(list of files, cad)

Other CAD files:
enclosure/out/stylosynth_enclosures.blend
