pringithub/stylosynth-555/docs/report/figures/ladder.pdf

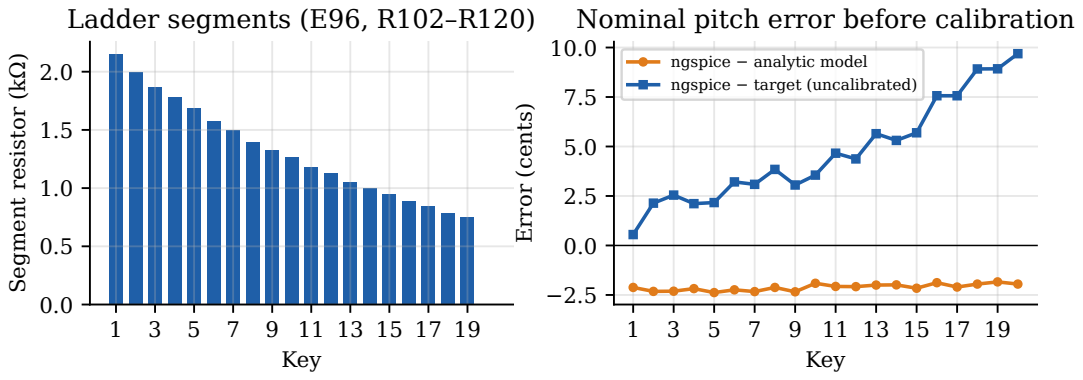
[picture p30: page 1]
1 3 5 7 9 11 13 15 17 19 Key; Ladder segments (E96, R102–R120); Error (cents)

Nominal pitch error before calibration

Segment resistor (kΩ)

ngspice − analytic model
ngspice − target (uncalibrated)
