pringithub/stylosynth-555/hardware/fab/stylosynth-bottom.pdf

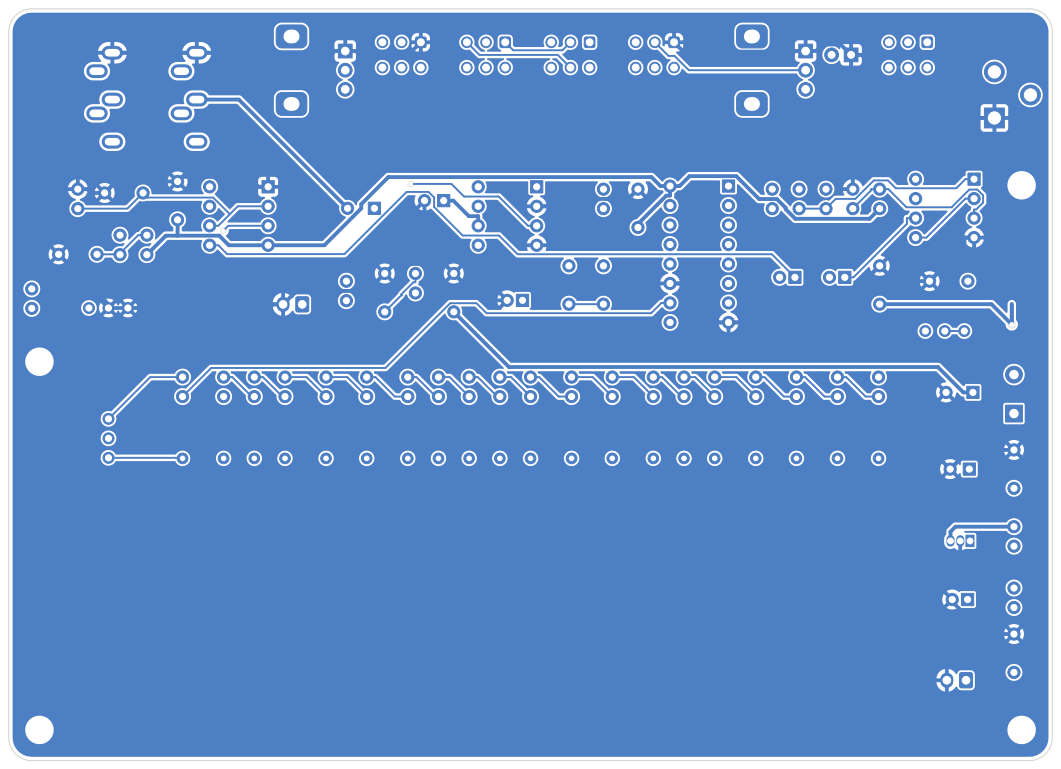
[picture p31: page 1]
