pringithub/stylosynth-555/hardware/fab/stylosynth-top.pdf

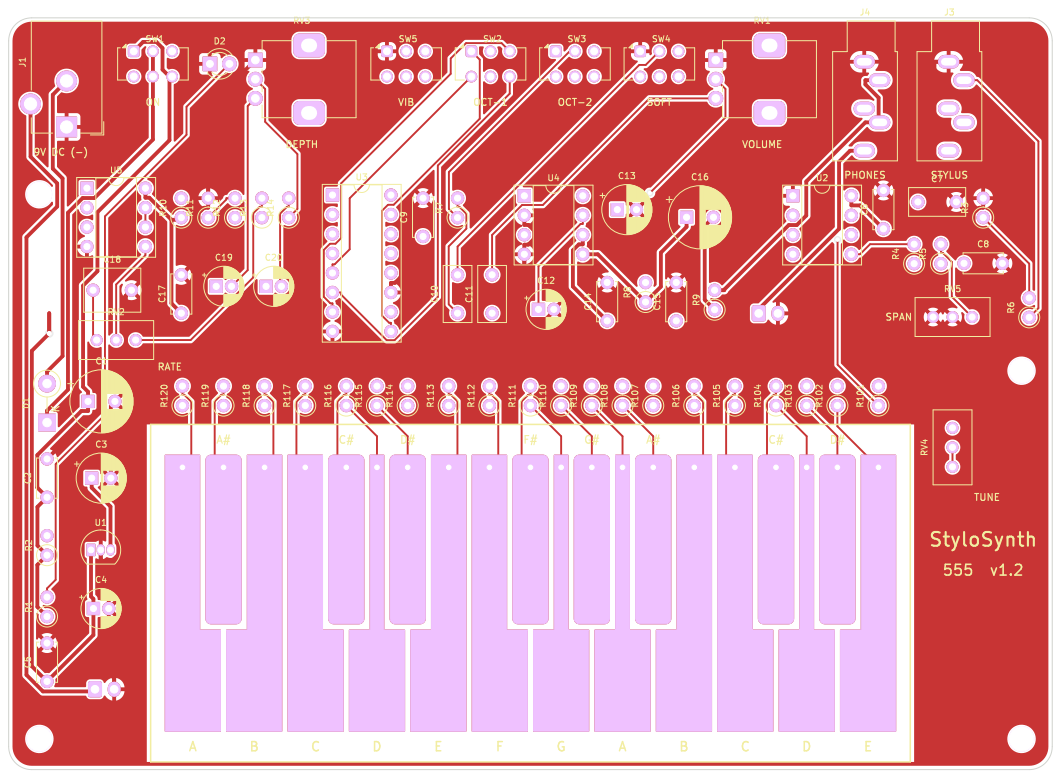
[picture p32: page 1]
