pringithub/stylosynth-555/hardware/kicad/stylosynth_schematic.pdf

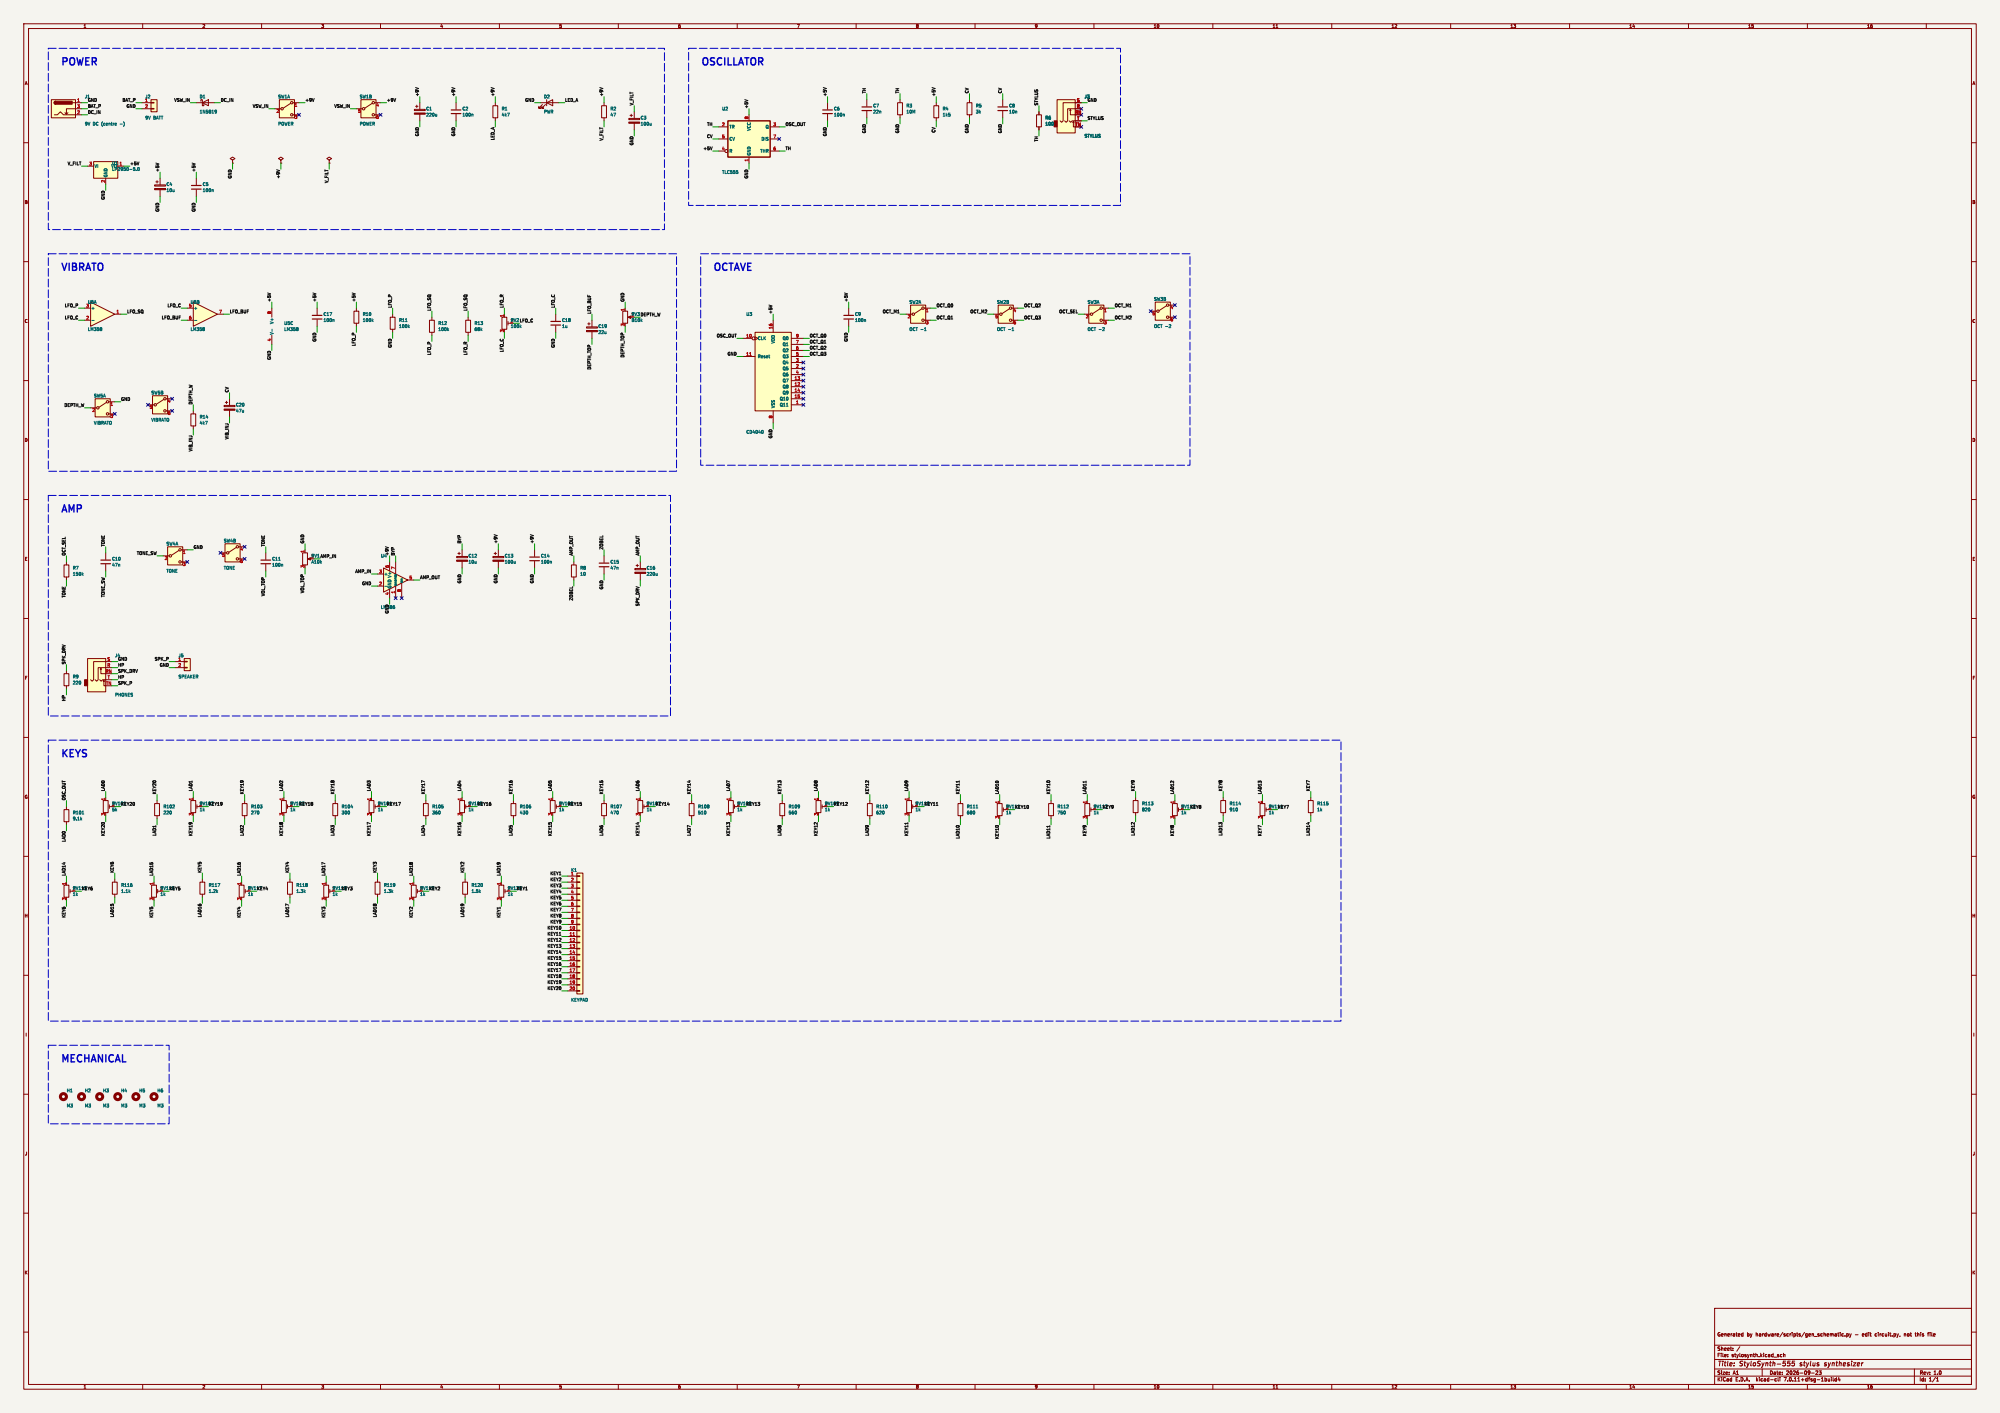
[picture p33: page 1]
