pringithub/stylosynth-555/docs/report/figures/note_map.pdf

10

## Note map: 20 keys × 4 octave settings (exact ×2 steps from the CD4040)

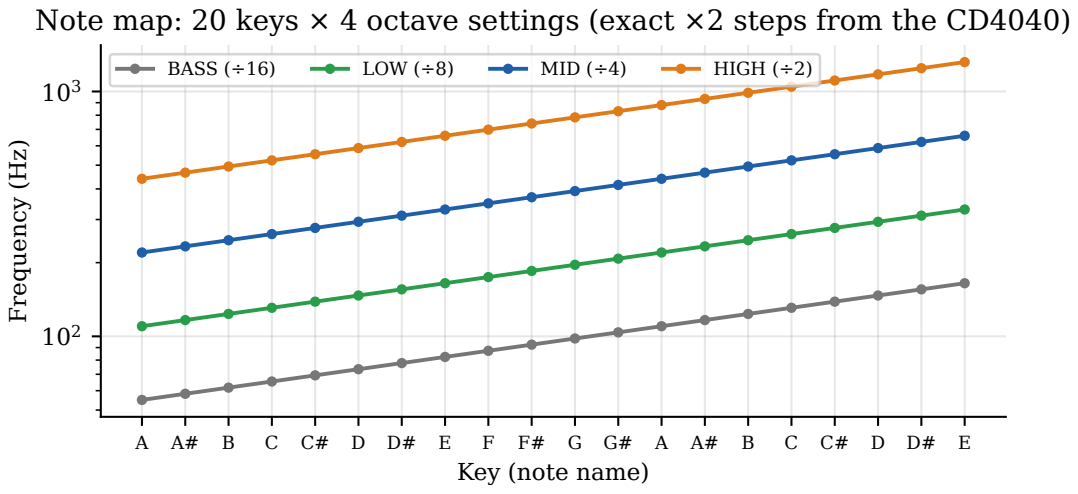
[picture p34: page 1]
Frequency (Hz); BASS (÷16); LOW (÷8); MID (÷4); HIGH (÷2)

Key (note name)
