pringithub/stylosynth-555/docs/report/figures/pcb_back.pdf

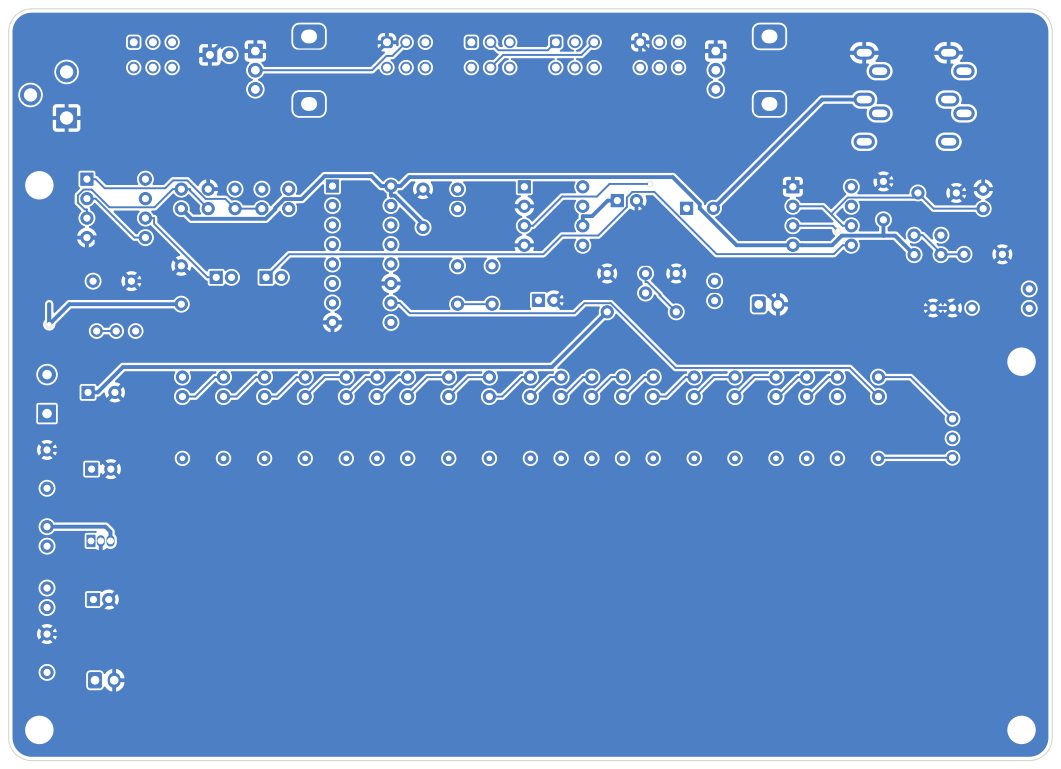
[picture p35: page 1]
