pringithub/stylosynth-555/docs/report/figures/pcb_copper.pdf

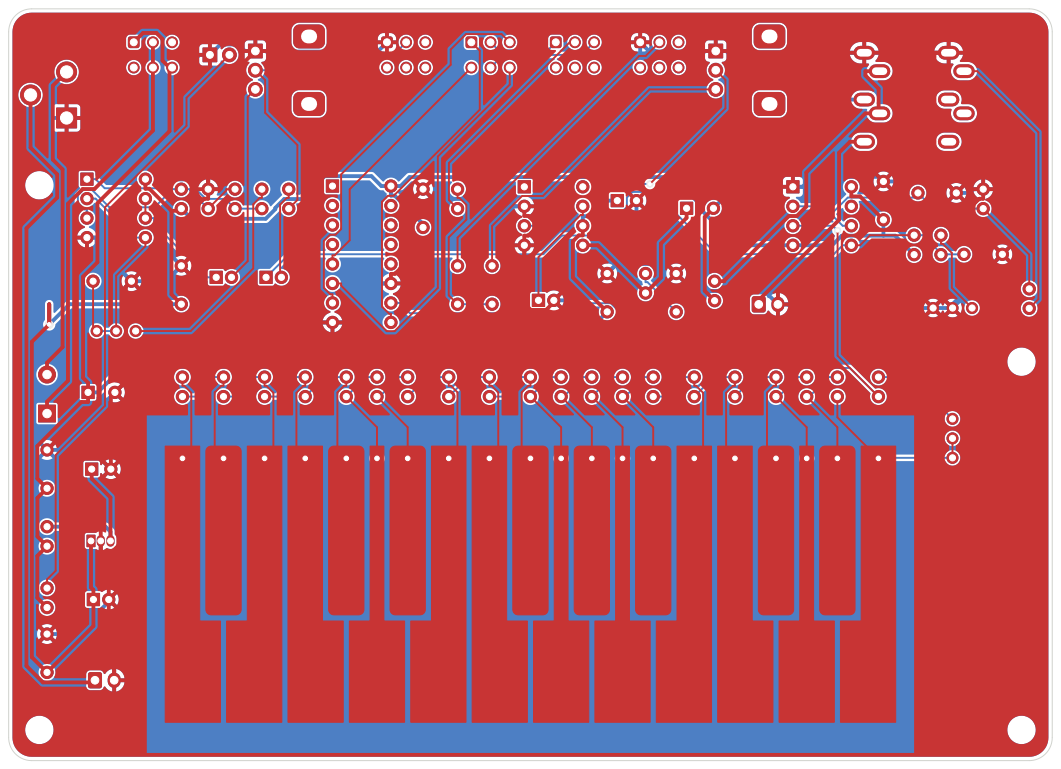
[picture p36: page 1]
