pringithub/stylosynth-555/docs/report/figures/pcb_front.pdf

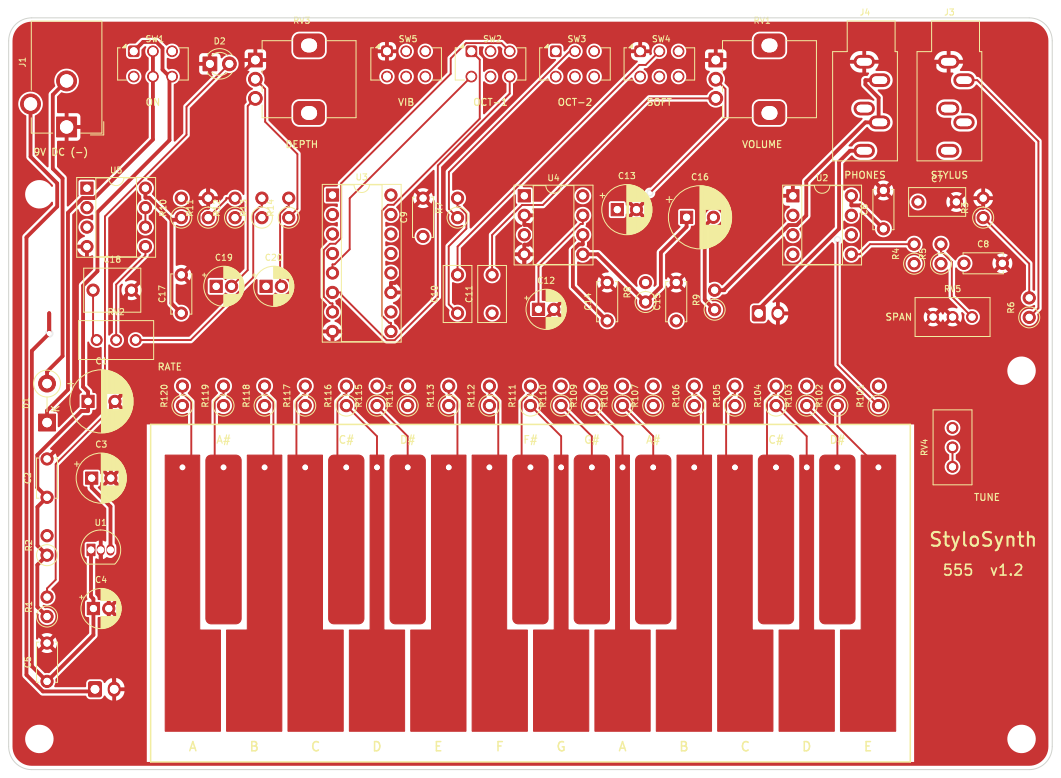
[picture p37: page 1]
