pringithub/stylosynth-555/docs/report/figures/schematic.pdf

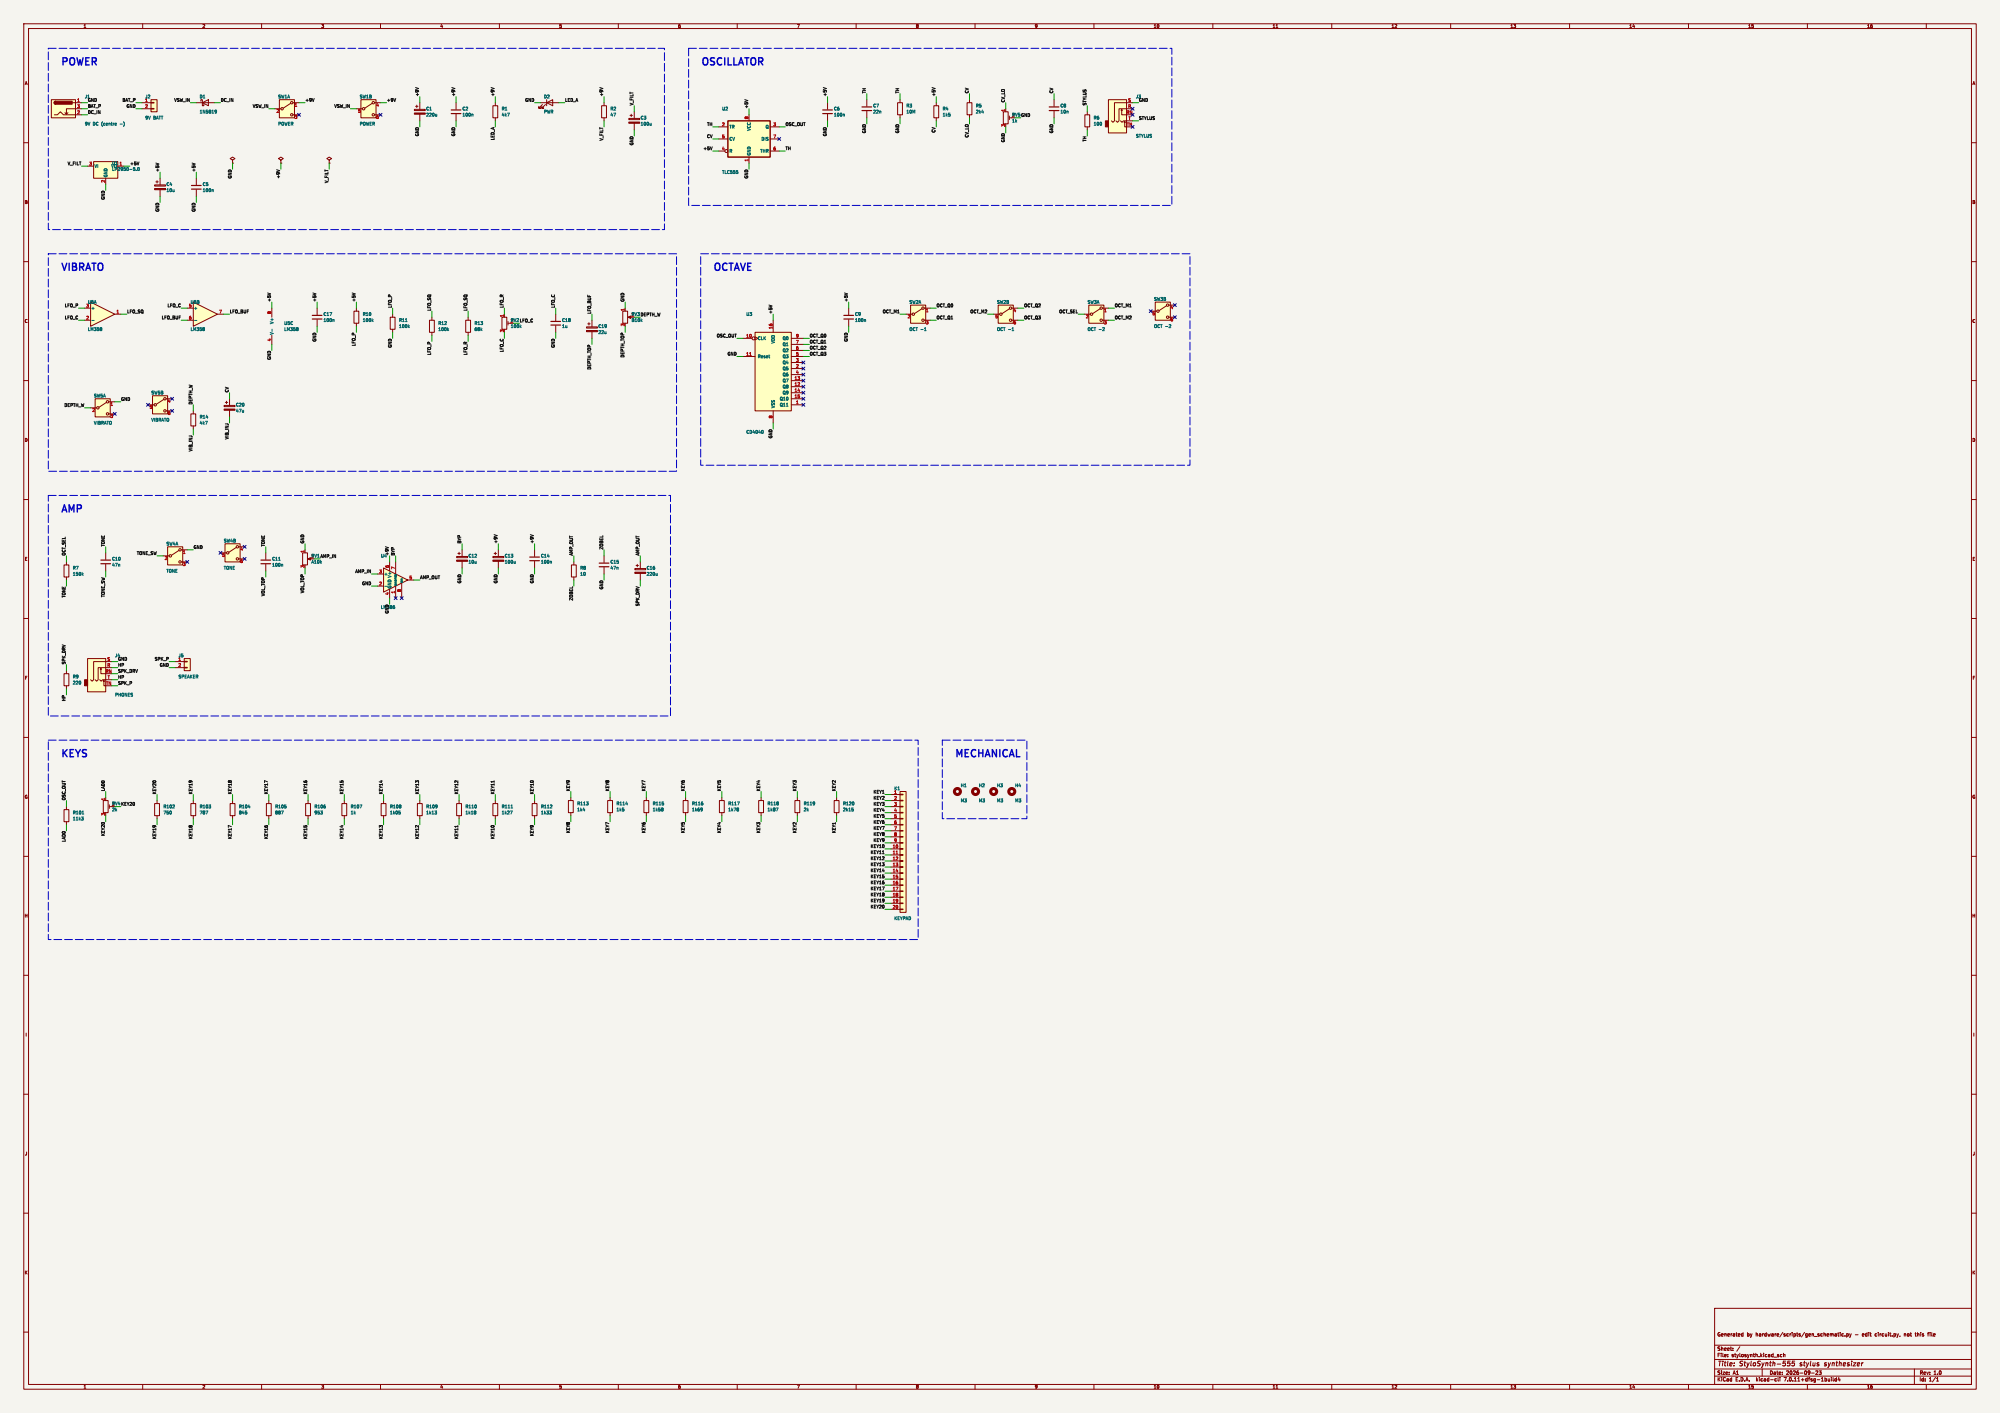
[picture p38: page 1]
