pringithub/stylosynth-555/(list of files, drawings)

Other design files:
enclosure/out/pcb_geometry.json
hardware/kicad/stylosynth.dsn
