pringithub/stylosynth-555/hardware/kicad/stylosynth.kicad_pcb

## KiCad design hardware/kicad/stylosynth.kicad_pcb (2026-09-23)

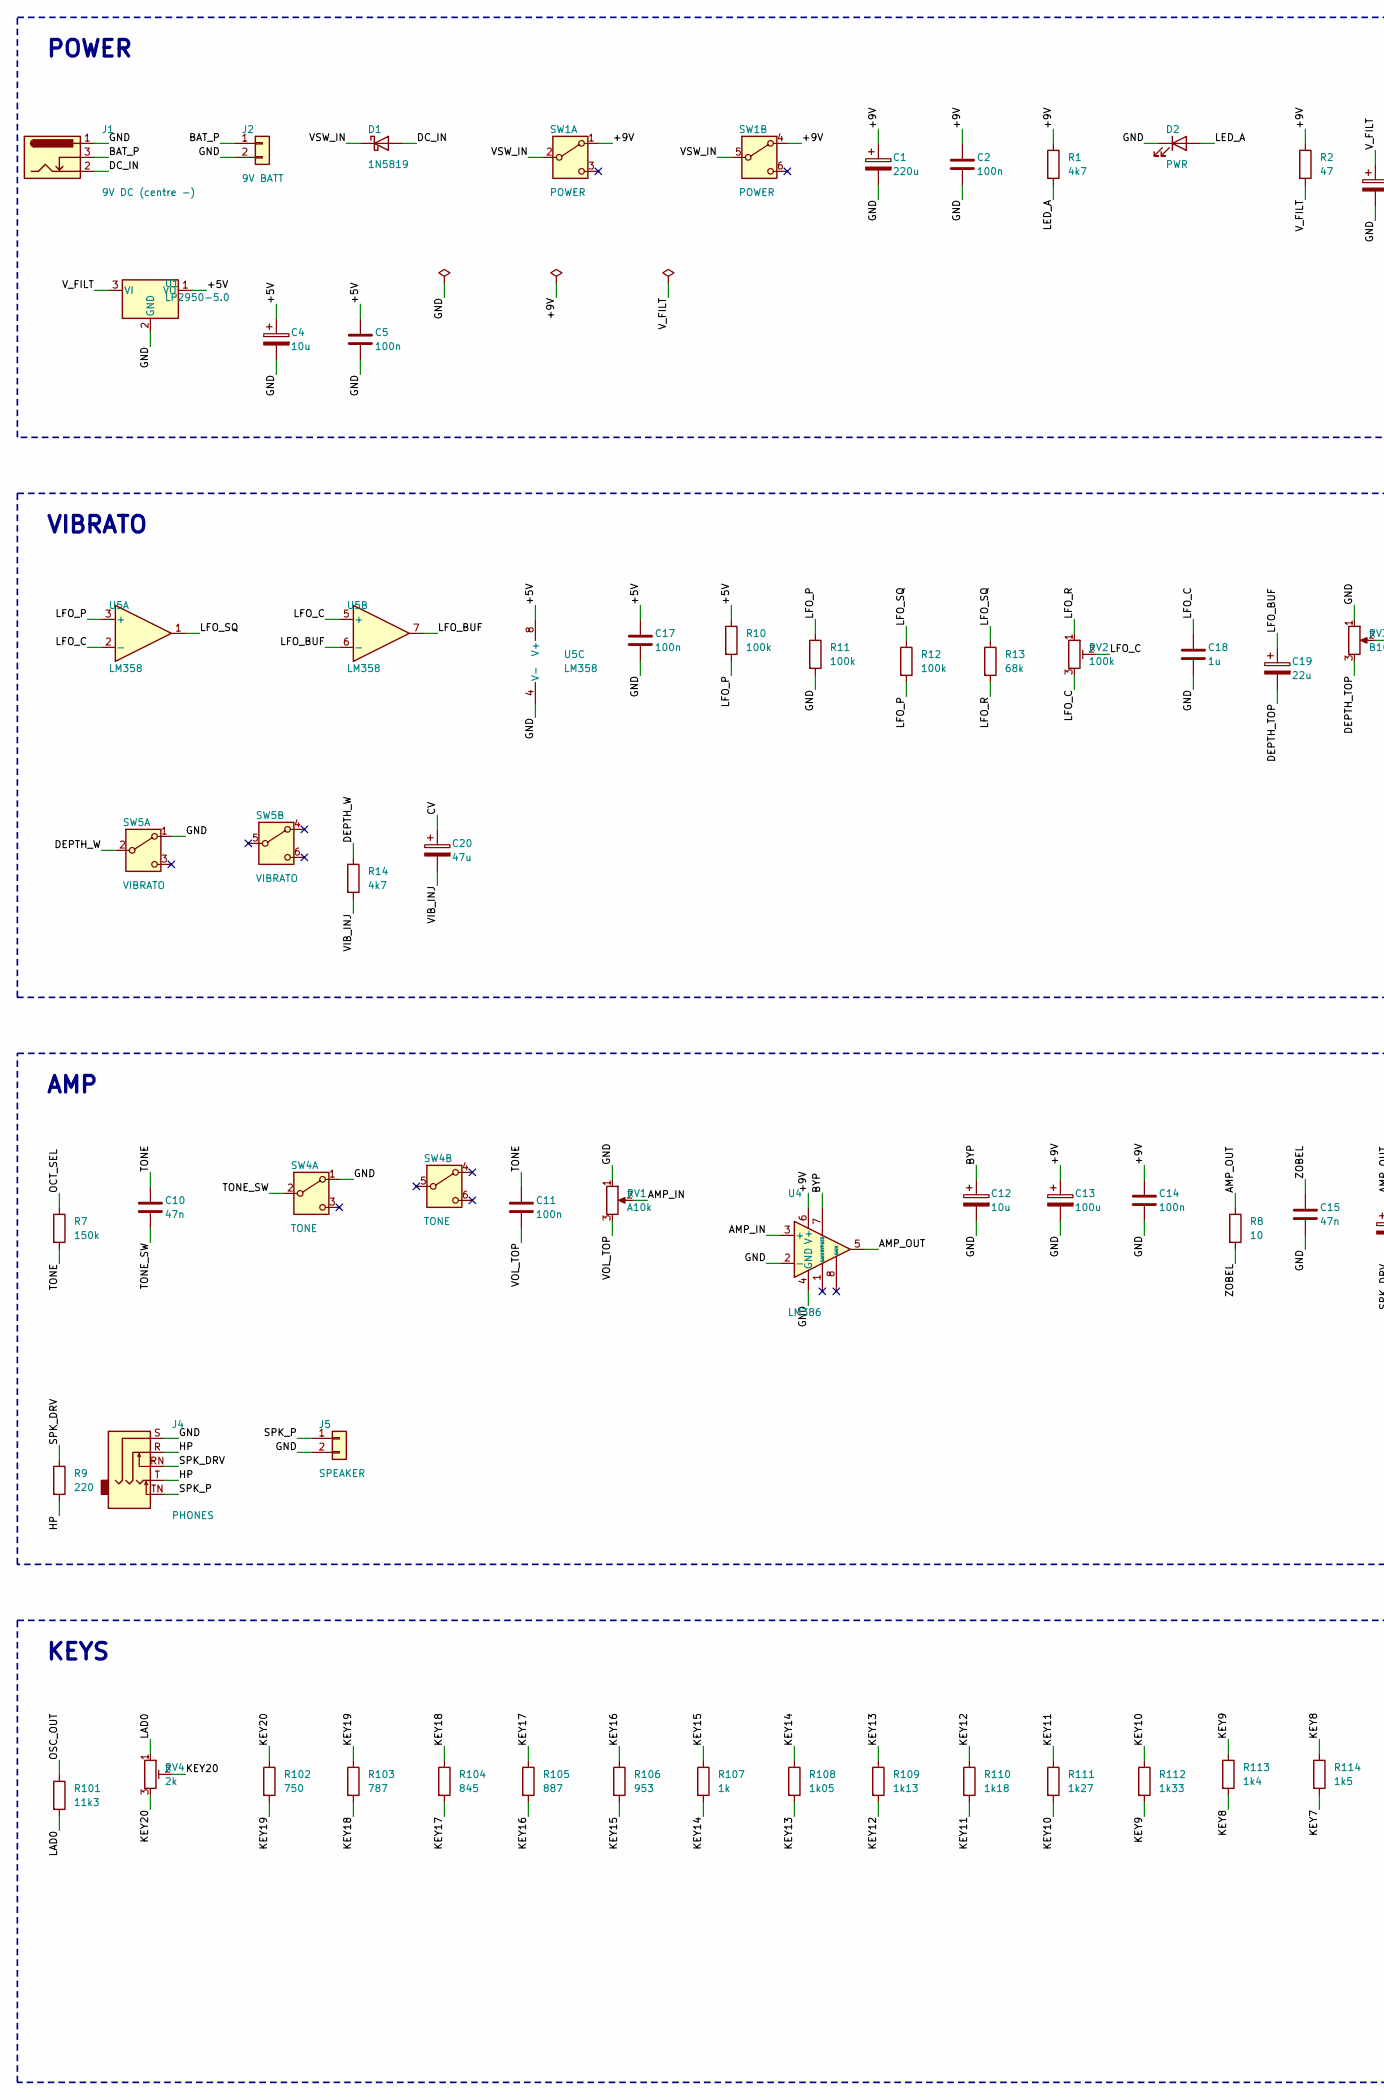
[picture p39: schematic stylosynth.kicad_sch, StyloSynth-555 stylus synthesizer, part in row 1, column 1]

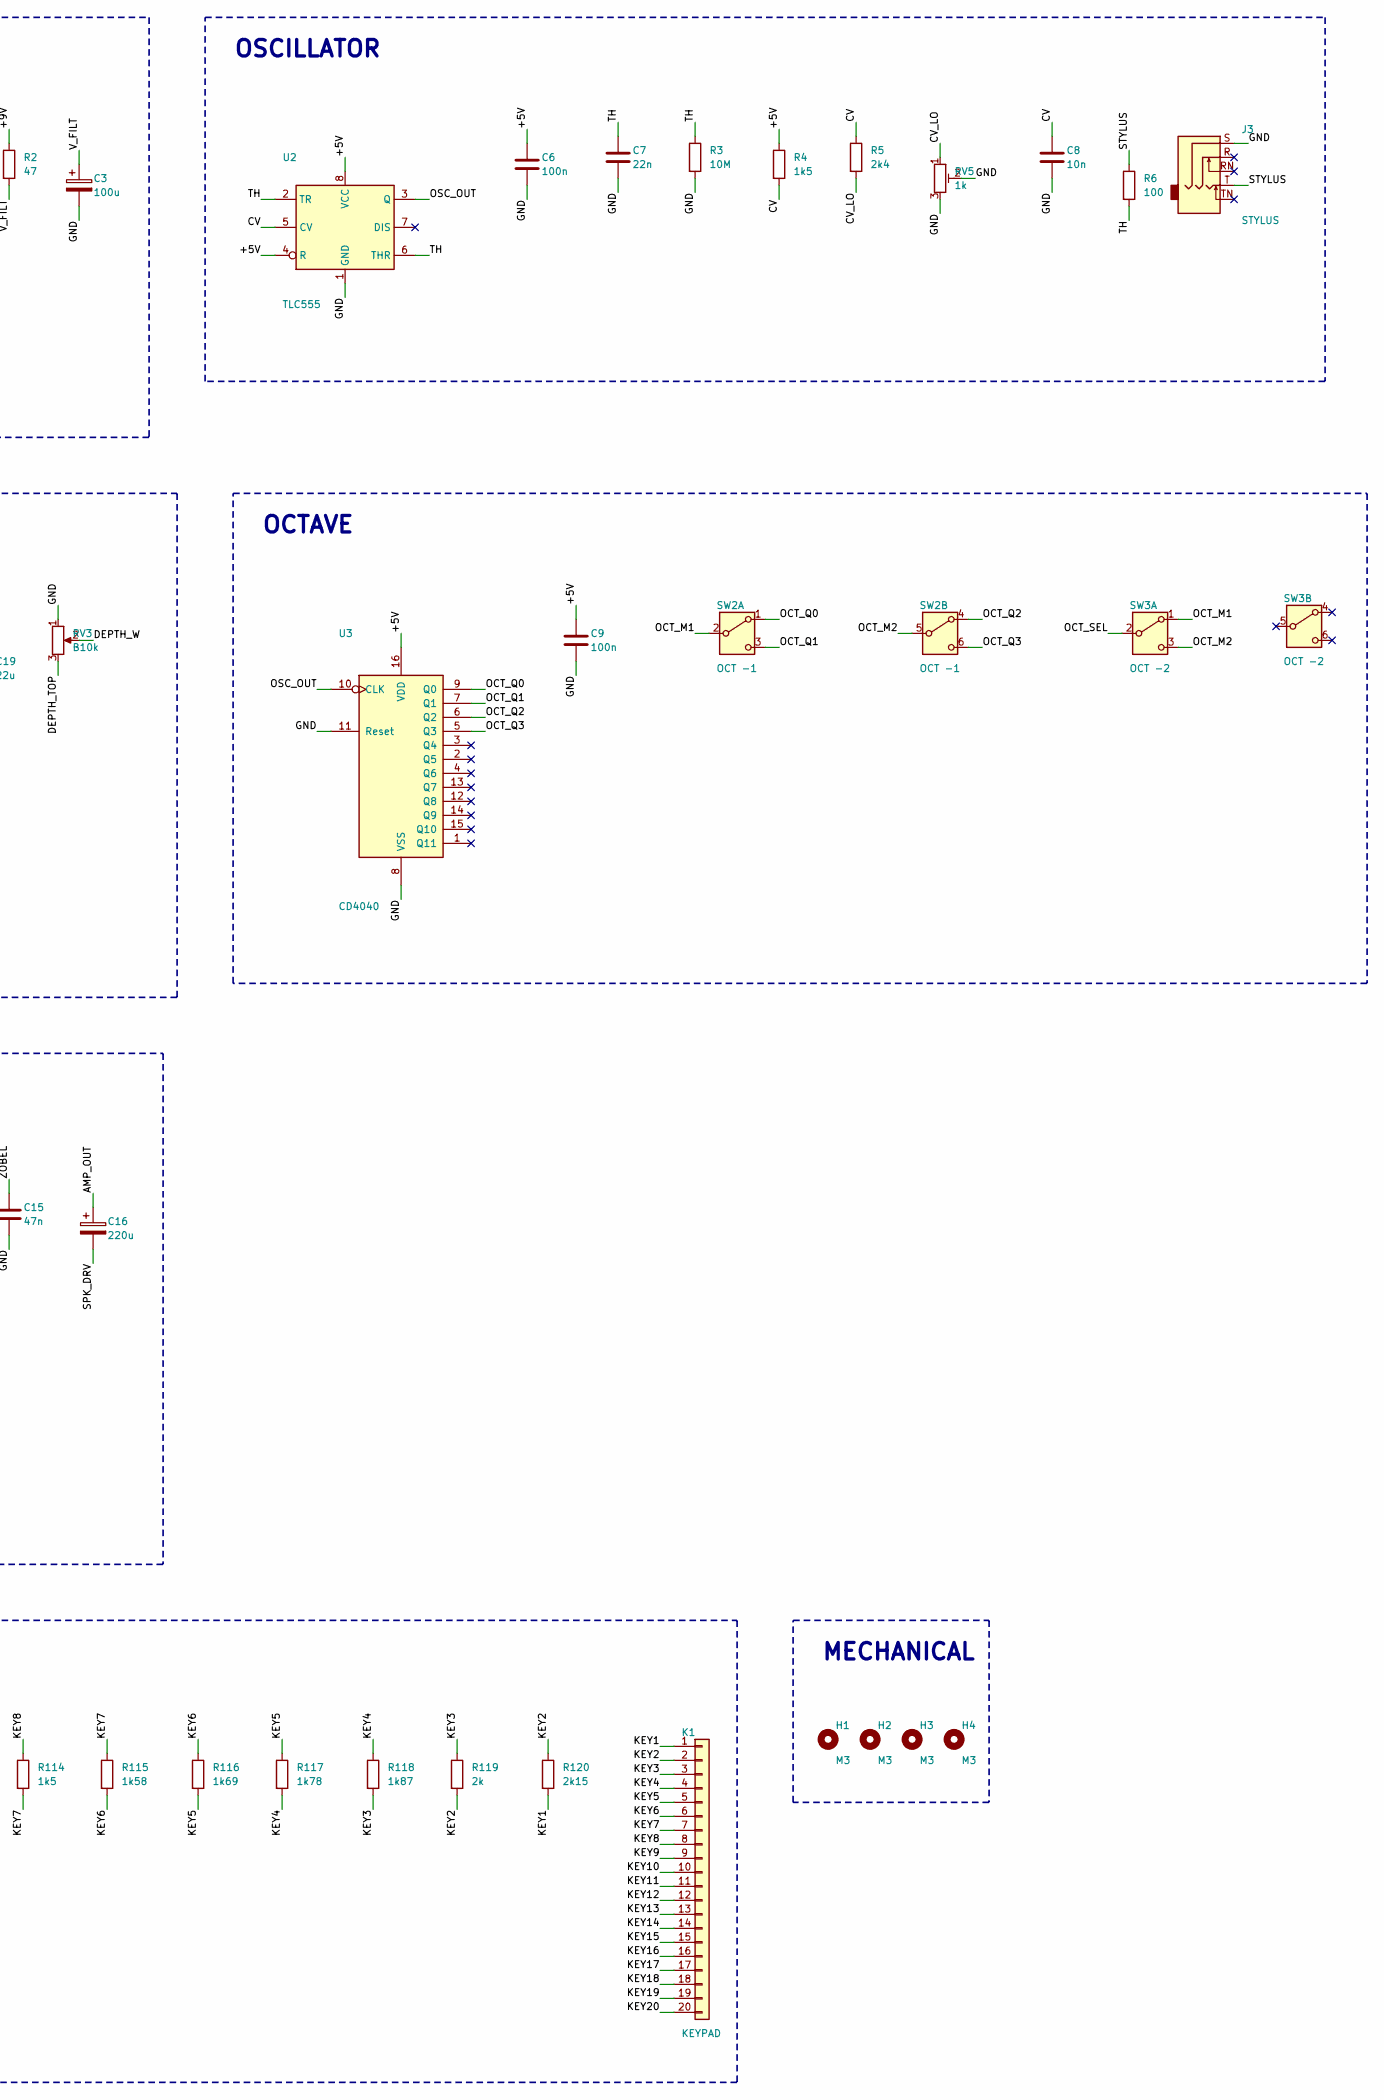
[picture p40: schematic stylosynth.kicad_sch, StyloSynth-555 stylus synthesizer, part in row 1, column 2]

Parts:
C1, C16: 220u; CP_Radial_D8.0mm_P3.50mm
C2, C5, C6, C9, C14, C17: 100n; C_Disc_D5.0mm_W2.5mm_P5.00mm
C3, C13: 100u; CP_Radial_D6.3mm_P2.50mm
C4, C12: 10u; CP_Radial_D5.0mm_P2.00mm
C7: 22n; C_Rect_L7.2mm_W3.5mm_P5.00mm_FKS2_FKP2_MKS2_MKP2
C8: 10n; C_Disc_D5.0mm_W2.5mm_P5.00mm
C10: 47n; C_Rect_L7.2mm_W3.5mm_P5.00mm_FKS2_FKP2_MKS2_MKP2
C11: 100n; C_Rect_L7.2mm_W3.5mm_P5.00mm_FKS2_FKP2_MKS2_MKP2
C15: 47n; C_Disc_D5.0mm_W2.5mm_P5.00mm
C18: 1u; C_Rect_L7.2mm_W5.5mm_P5.00mm_FKS2_FKP2_MKS2_MKP2
C19: 22u; CP_Radial_D5.0mm_P2.00mm
C20: 47u; CP_Radial_D5.0mm_P2.00mm
D1: 1N5819; D_DO-41_SOD81_P5.08mm_Vertical_KathodeUp; MPN 1N5819
D2: PWR; LED_D3.0mm
H1, H2, H3, H4: M3; MountingHole_3.2mm_M3
J1: 9V DC (centre -); BarrelJack_CUI_PJ-102AH_Horizontal; MPN PJ-102AH
J2: 9V BATT; JST_XH_B2B-XH-A_1x02_P2.50mm_Vertical; MPN B2B-XH-A
J3: STYLUS; Jack_3.5mm_CUI_SJ1-3535NG_Horizontal; MPN SJ1-3535NG
J4: PHONES; Jack_3.5mm_CUI_SJ1-3535NG_Horizontal; MPN SJ1-3535NG
J5: SPEAKER; JST_XH_B2B-XH-A_1x02_P2.50mm_Vertical; MPN B2B-XH-A
K1: KEYPAD; KEYPAD_20
R1, R14: 4k7; R_Axial_DIN0207_L6.3mm_D2.5mm_P2.54mm_Vertical
R2: 47; R_Axial_DIN0207_L6.3mm_D2.5mm_P2.54mm_Vertical
R3: 10M; R_Axial_DIN0207_L6.3mm_D2.5mm_P2.54mm_Vertical
R4, R114: 1k5; R_Axial_DIN0207_L6.3mm_D2.5mm_P2.54mm_Vertical
R5: 2k4; R_Axial_DIN0207_L6.3mm_D2.5mm_P2.54mm_Vertical
R6: 100; R_Axial_DIN0207_L6.3mm_D2.5mm_P2.54mm_Vertical
R7: 150k; R_Axial_DIN0207_L6.3mm_D2.5mm_P2.54mm_Vertical
R8: 10; R_Axial_DIN0207_L6.3mm_D2.5mm_P2.54mm_Vertical
R9: 220; R_Axial_DIN0207_L6.3mm_D2.5mm_P2.54mm_Vertical
R10, R11, R12: 100k; R_Axial_DIN0207_L6.3mm_D2.5mm_P2.54mm_Vertical
R13: 68k; R_Axial_DIN0207_L6.3mm_D2.5mm_P2.54mm_Vertical
R101: 11k3; R_Axial_DIN0207_L6.3mm_D2.5mm_P2.54mm_Vertical
R102: 750; R_Axial_DIN0207_L6.3mm_D2.5mm_P2.54mm_Vertical
R103: 787; R_Axial_DIN0207_L6.3mm_D2.5mm_P2.54mm_Vertical
R104: 845; R_Axial_DIN0207_L6.3mm_D2.5mm_P2.54mm_Vertical
R105: 887; R_Axial_DIN0207_L6.3mm_D2.5mm_P2.54mm_Vertical
R106: 953; R_Axial_DIN0207_L6.3mm_D2.5mm_P2.54mm_Vertical
R107: 1k; R_Axial_DIN0207_L6.3mm_D2.5mm_P2.54mm_Vertical
R108: 1k05; R_Axial_DIN0207_L6.3mm_D2.5mm_P2.54mm_Vertical
R109: 1k13; R_Axial_DIN0207_L6.3mm_D2.5mm_P2.54mm_Vertical
R110: 1k18; R_Axial_DIN0207_L6.3mm_D2.5mm_P2.54mm_Vertical
R111: 1k27; R_Axial_DIN0207_L6.3mm_D2.5mm_P2.54mm_Vertical
R112: 1k33; R_Axial_DIN0207_L6.3mm_D2.5mm_P2.54mm_Vertical
R113: 1k4; R_Axial_DIN0207_L6.3mm_D2.5mm_P2.54mm_Vertical
R115: 1k58; R_Axial_DIN0207_L6.3mm_D2.5mm_P2.54mm_Vertical
R116: 1k69; R_Axial_DIN0207_L6.3mm_D2.5mm_P2.54mm_Vertical
R117: 1k78; R_Axial_DIN0207_L6.3mm_D2.5mm_P2.54mm_Vertical
R118: 1k87; R_Axial_DIN0207_L6.3mm_D2.5mm_P2.54mm_Vertical
R119: 2k; R_Axial_DIN0207_L6.3mm_D2.5mm_P2.54mm_Vertical
R120: 2k15; R_Axial_DIN0207_L6.3mm_D2.5mm_P2.54mm_Vertical
RV1: A10k; Potentiometer_Alps_RK09K_Single_Vertical; MPN RK09K1130A5R
RV2: 100k; Potentiometer_Bourns_3296W_Vertical; MPN 3296W-1-104
RV3: B10k; Potentiometer_Alps_RK09K_Single_Vertical; MPN RK09K1130A8G
RV4: 2k; Potentiometer_Bourns_3296W_Vertical; MPN 3296W-1-202LF
RV5: 1k; Potentiometer_Bourns_3296W_Vertical; MPN 3296W-1-102LF
SW1: POWER; SW_CK_JS202011CQN_DPDT_Straight; MPN JS202011CQN
SW2: OCT -1; SW_CK_JS202011CQN_DPDT_Straight; MPN JS202011CQN
SW3: OCT -2; SW_CK_JS202011CQN_DPDT_Straight; MPN JS202011CQN
SW4: TONE; SW_CK_JS202011CQN_DPDT_Straight; MPN JS202011CQN
SW5: VIBRATO; SW_CK_JS202011CQN_DPDT_Straight; MPN JS202011CQN
U1: LP2950-5.0; TO-92_Inline; MPN LP2950ACZ-5.0
U2: TLC555; DIP-8_W7.62mm_Socket; MPN TLC555CP
U3: CD4040; DIP-16_W7.62mm_Socket; MPN CD4040BE
U4: LM386; DIP-8_W7.62mm_Socket; MPN LM386N-1
U5: LM358; DIP-8_W7.62mm_Socket; MPN LM358P

Connections:
+5V: C4.1, C5.1, C6.1, C9.1, C17.1, R4.1, R10.1, U1.1 (VO), U2.4 (R), U2.8 (VCC), U3.16 (VDD), U5.8 (V+)
+9V: C1.1, C2.1, C13.1, C14.1, R1.1, R2.1, SW1.1 (A), SW1.4 (A), U4.6 (V+)
AMP_IN: RV1.2, U4.3 (+)
AMP_OUT: C16.1, R8.1, U4.5
BAT_P: J1.3, J2.1
BYP: C12.1, U4.7 (BYPASS)
CV: C8.1, C20.1, R4.2, R5.1, U2.5 (CV)
CV_LO: R5.2, RV5.1
DC_IN: D1.2 (A), J1.2
DEPTH_TOP: C19.2, RV3.3
DEPTH_W: R14.1, RV3.2, SW5.2 (B)
GND: C1.2, C2.2, C3.2, C4.2, C5.2, C6.2, C7.2, C8.2, C9.2, C12.2, C13.2, C14.2, C15.2, C17.2, C18.2, D2.1 (K), J1.1, J2.2, J3.S, J4.S, J5.2, R3.2, R11.2, RV1.1, RV3.1, RV5.2, RV5.3, SW4.1 (A), SW5.1 (A), U1.2 (GND), U2.1 (GND), U3.8 (VSS), U3.11 (Reset), U4.2 (-), U4.4 (GND), U5.4 (V-)
HP: J4.R, J4.T, R9.2
KEY1: K1.1, R120.2
KEY2: K1.2, R119.2, R120.1
KEY3: K1.3, R118.2, R119.1
KEY4: K1.4, R117.2, R118.1
KEY5: K1.5, R116.2, R117.1
KEY6: K1.6, R115.2, R116.1
KEY7: K1.7, R114.2, R115.1
KEY8: K1.8, R113.2, R114.1
KEY9: K1.9, R112.2, R113.1
KEY10: K1.10, R111.2, R112.1
KEY11: K1.11, R110.2, R111.1
KEY12: K1.12, R109.2, R110.1
KEY13: K1.13, R108.2, R109.1
KEY14: K1.14, R107.2, R108.1
KEY15: K1.15, R106.2, R107.1
KEY16: K1.16, R105.2, R106.1
KEY17: K1.17, R104.2, R105.1
KEY18: K1.18, R103.2, R104.1
KEY19: K1.19, R102.2, R103.1
KEY20: K1.20, R102.1, RV4.2, RV4.3
LAD0: R101.2, RV4.1
LED_A: D2.2 (A), R1.2
LFO_BUF: C19.1, U5.6 (-), U5.7
LFO_C: C18.1, RV2.2, RV2.3, U5.2 (-), U5.5 (+)
LFO_P: R10.2, R11.1, R12.2, U5.3 (+)
LFO_R: R13.2, RV2.1
LFO_SQ: R12.1, R13.1, U5.1
OCT_M1: SW2.2 (B), SW3.1 (A)
OCT_M2: SW2.5 (B), SW3.3 (C)
OCT_Q0: SW2.1 (A), U3.9 (Q0)
OCT_Q1: SW2.3 (C), U3.7 (Q1)
OCT_Q2: SW2.4 (A), U3.6 (Q2)
OCT_Q3: SW2.6 (C), U3.5 (Q3)
OCT_SEL: R7.1, SW3.2 (B)
OSC_OUT: R101.1, U2.3 (Q), U3.10 (CLK)
SPK_DRV: C16.2, J4.RN, R9.1
SPK_P: J4.TN, J5.1
STYLUS: J3.T, R6.1
TH: C7.1, R3.1, R6.2, U2.2 (TR), U2.6 (THR)
TONE: C10.1, C11.1, R7.2
TONE_SW: C10.2, SW4.2 (B)
VIB_INJ: C20.2, R14.2
VOL_TOP: C11.2, RV1.3
VSW_IN: D1.1 (K), SW1.2 (B), SW1.5 (B)
V_FILT: C3.1, R2.2, U1.3 (VI)
ZOBEL: C15.1, R8.2

Notes on the sheet:
POWER
OSCILLATOR
VIBRATO
OCTAVE
AMP
KEYS
MECHANICAL

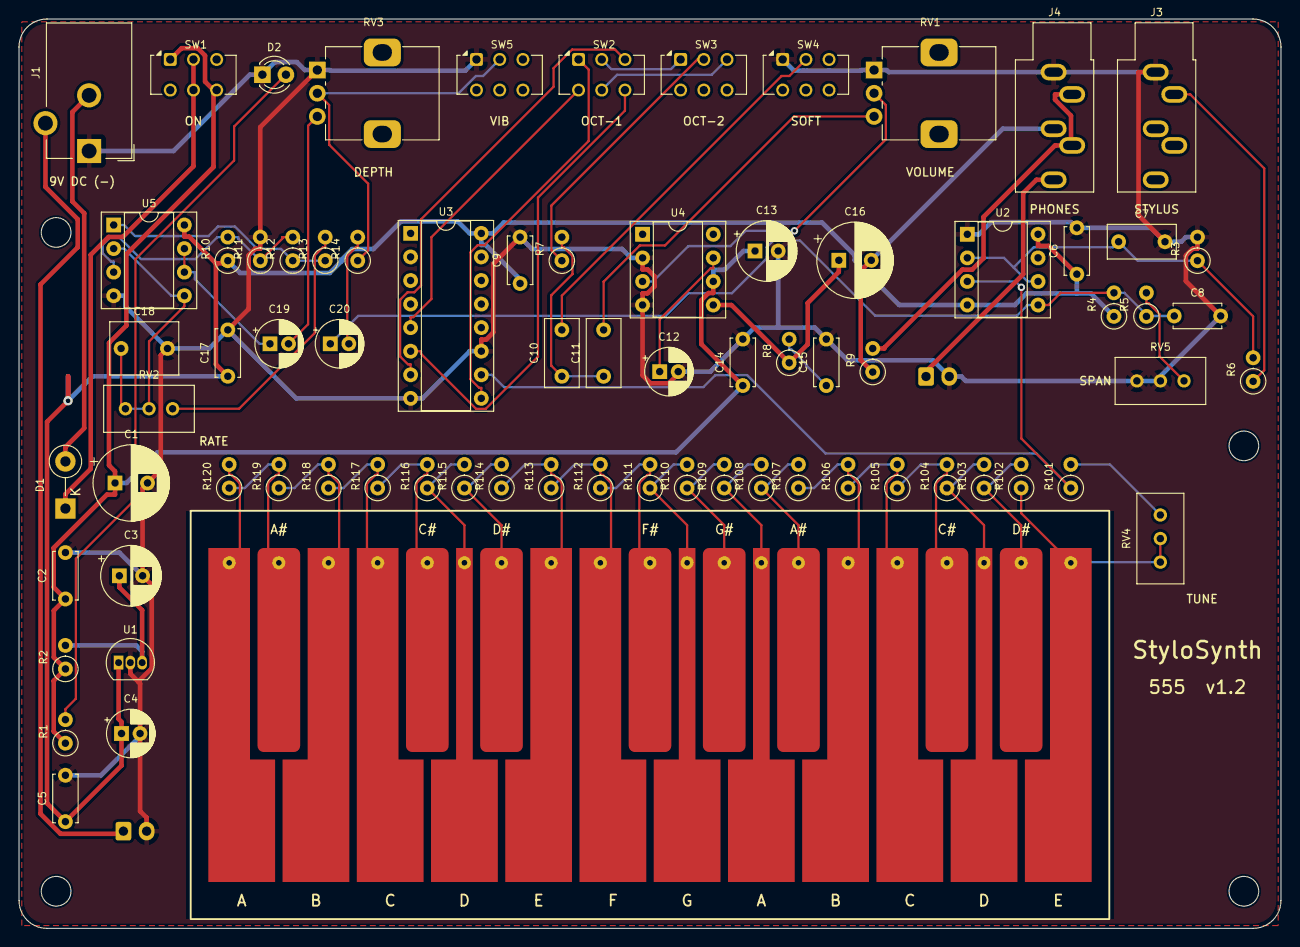
[picture p41: board stylosynth.kicad_pcb from above]

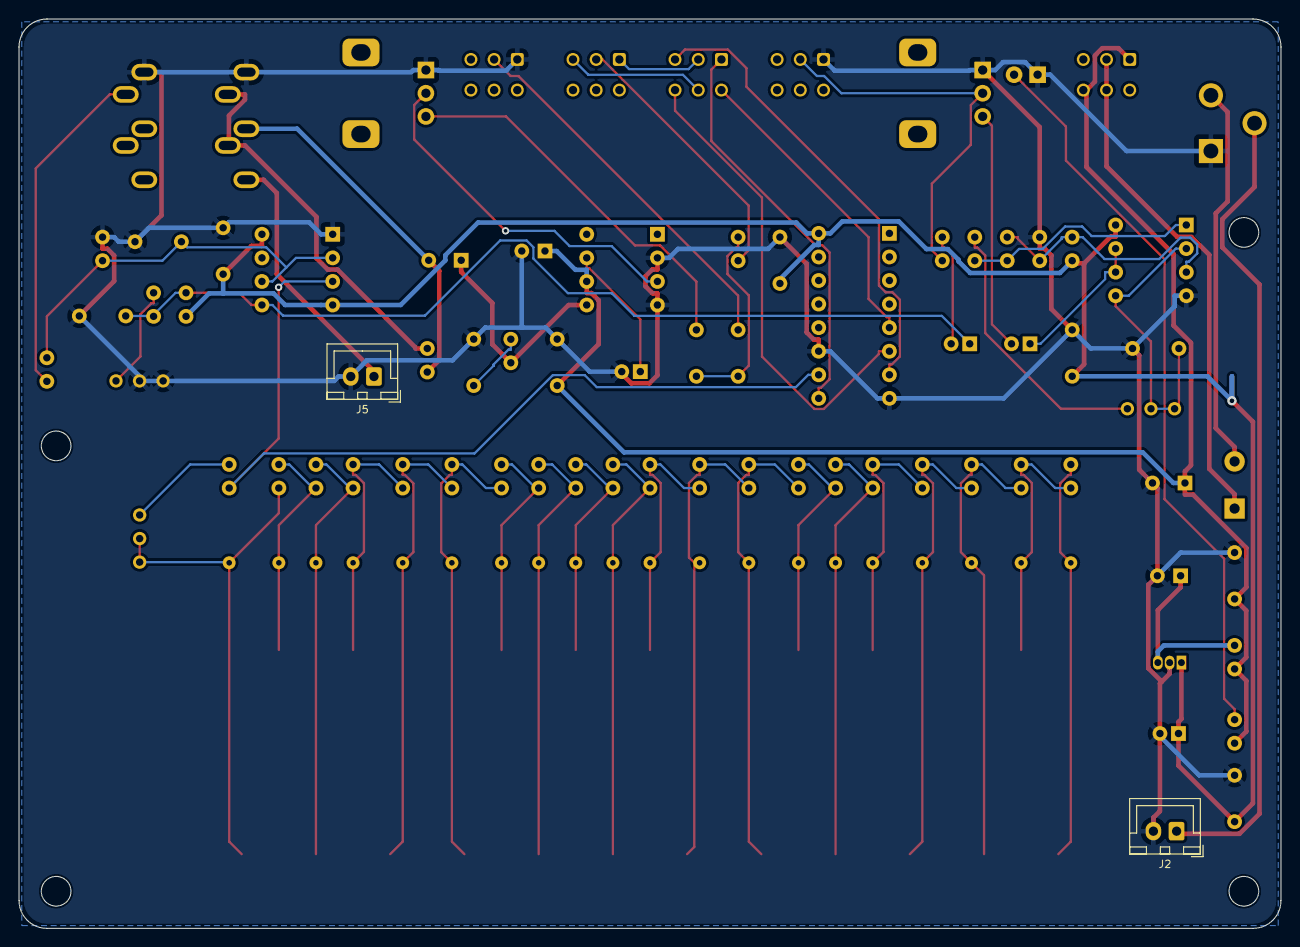
[picture p42: board stylosynth.kicad_pcb from below]

Board: 2 copper layers, 136.0 x 98.0 mm, 81 parts (2 on the bottom side), 59 nets.
