pringithub/stylosynth-555/(commit log)

2026-09-23 Plan, ladder calc, simulations, circuit definition and generated schematic
    [ladder.csv, stylosynth.kicad_sch]
2026-09-23 Keypad footprint, PCB build pipeline, BOM, assembly/tuning docs, fab export script
    [bom.csv, stylosynth.dsn, stylosynth.kicad_pcb]
2026-09-23 v1.1: piano-layout keyboard, fixed E96 ladder with TUNE/SPAN calibration, 170x108 board
    [bom.csv, ladder.csv, stylosynth.dsn, stylosynth.kicad_pcb, stylosynth.kicad_sch]
2026-09-23 v1.2: compact 136x98 layout, vertical resistors, single ladder row
    [bom.csv, stylosynth.dsn, stylosynth.kicad_pcb, stylosynth.kicad_sch]
2026-09-23 Routed v1.2 board (DRC clean), enclosure geometry + Blender build scripts
    [bottom_plate_x1.dxf, pcb_geometry.json, ring_x8.dxf, stylosynth.dsn, stylosynth.kicad_pcb, stylosynth_enclosures.blend, stylus_body.stl, tray.stl]
2026-09-23 Printed + acrylic enclosures, Blender model, fab package, docs
    [bom.csv, bottom_plate_x1.dxf, pcb_geometry.json, ring_x8.dxf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]
2026-10-05 Add verify_all.py and electrical verification report
    [bom.csv]
2026-10-05 verify_all: fit check on committed board in temp dir
